nachobh/thermostat/WhatsApp Image 2026-09-09 at 20.18.24-2.jpeg

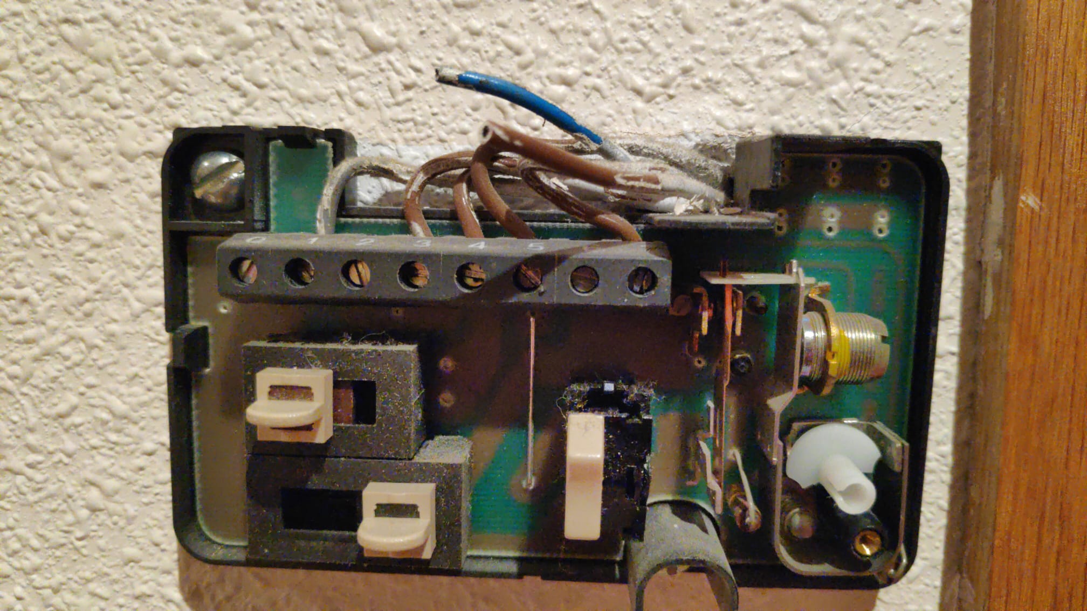
WhatsApp Image 2026-09-09 at 20.18.24-2.jpeg
