nachobh/thermostat/carcasa/esquema_medidas.png

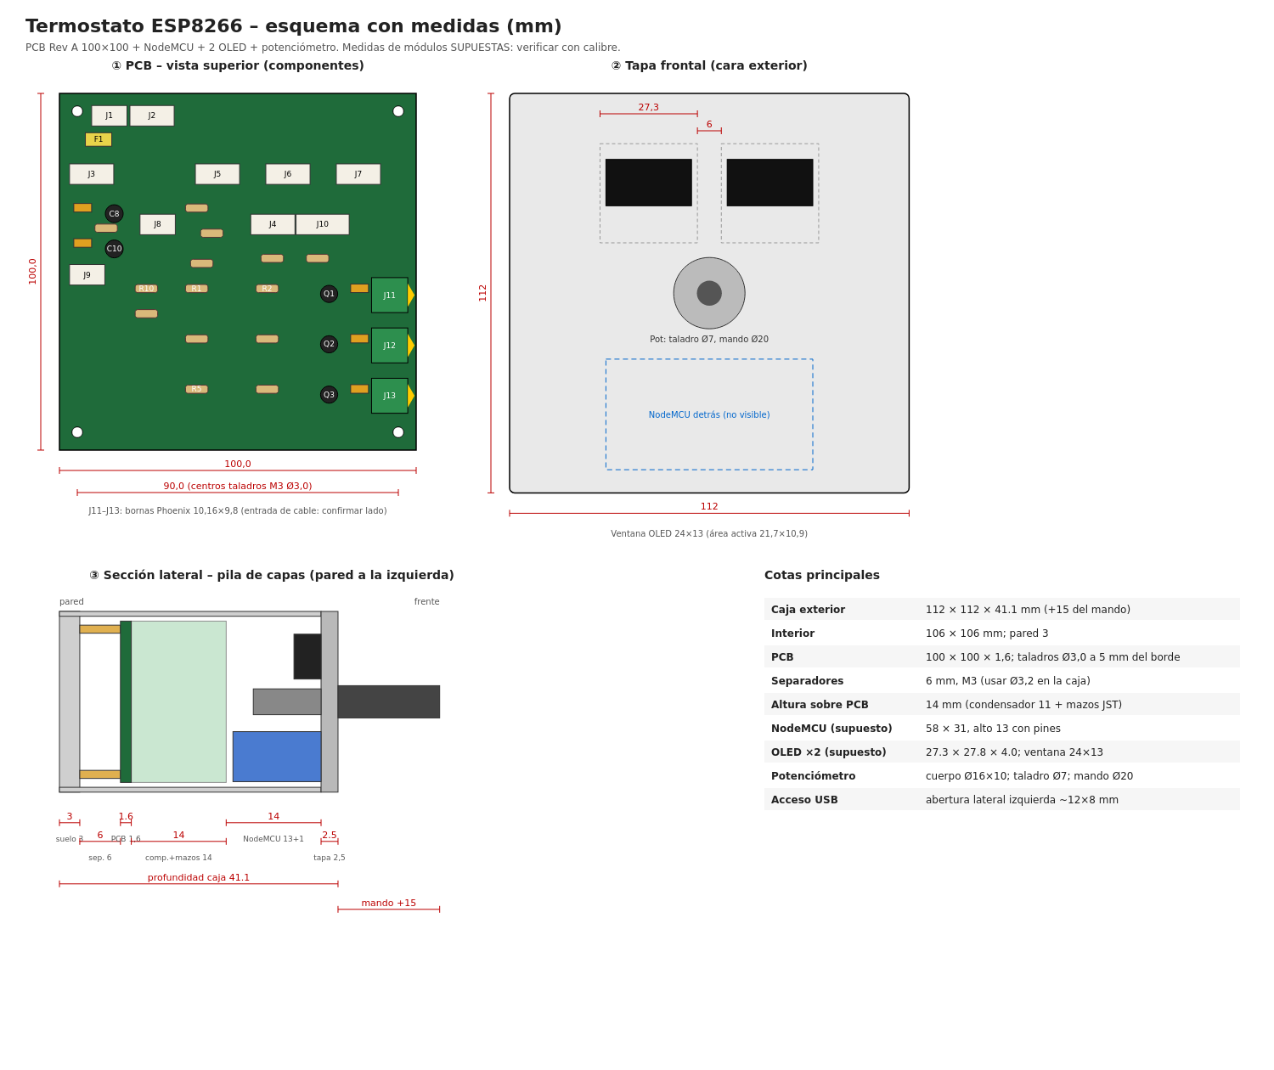
carcasa/esquema_medidas.png
