nachobh/thermostat/carcasa/esquema_v2.png

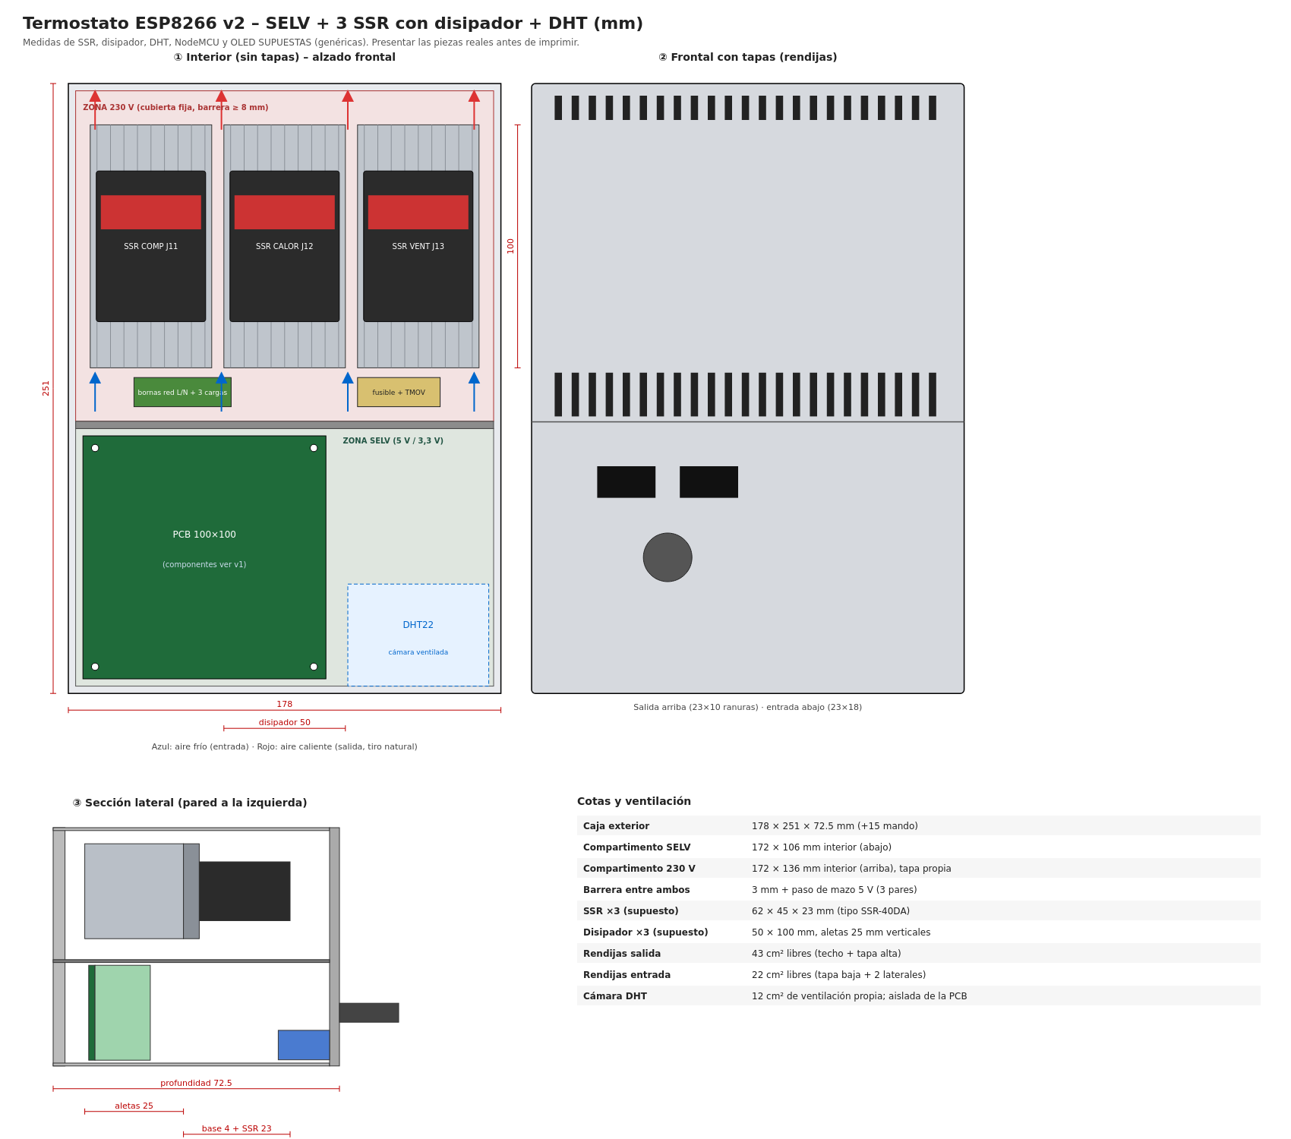
carcasa/esquema_v2.png
