nachobh/thermostat/carcasa/esquema_v3.png

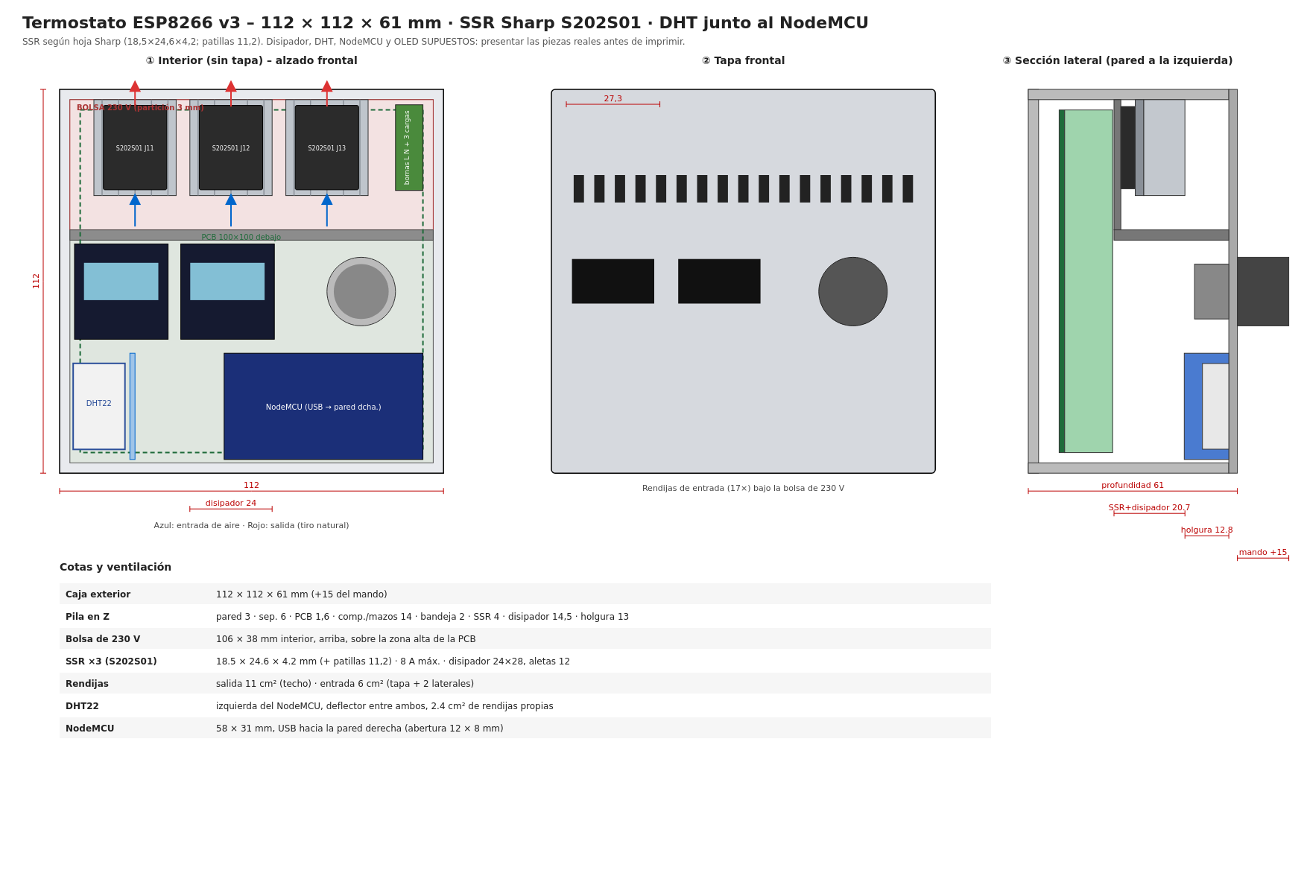
carcasa/esquema_v3.png
