nachobh/thermostat/carcasa/esquema_v5.png

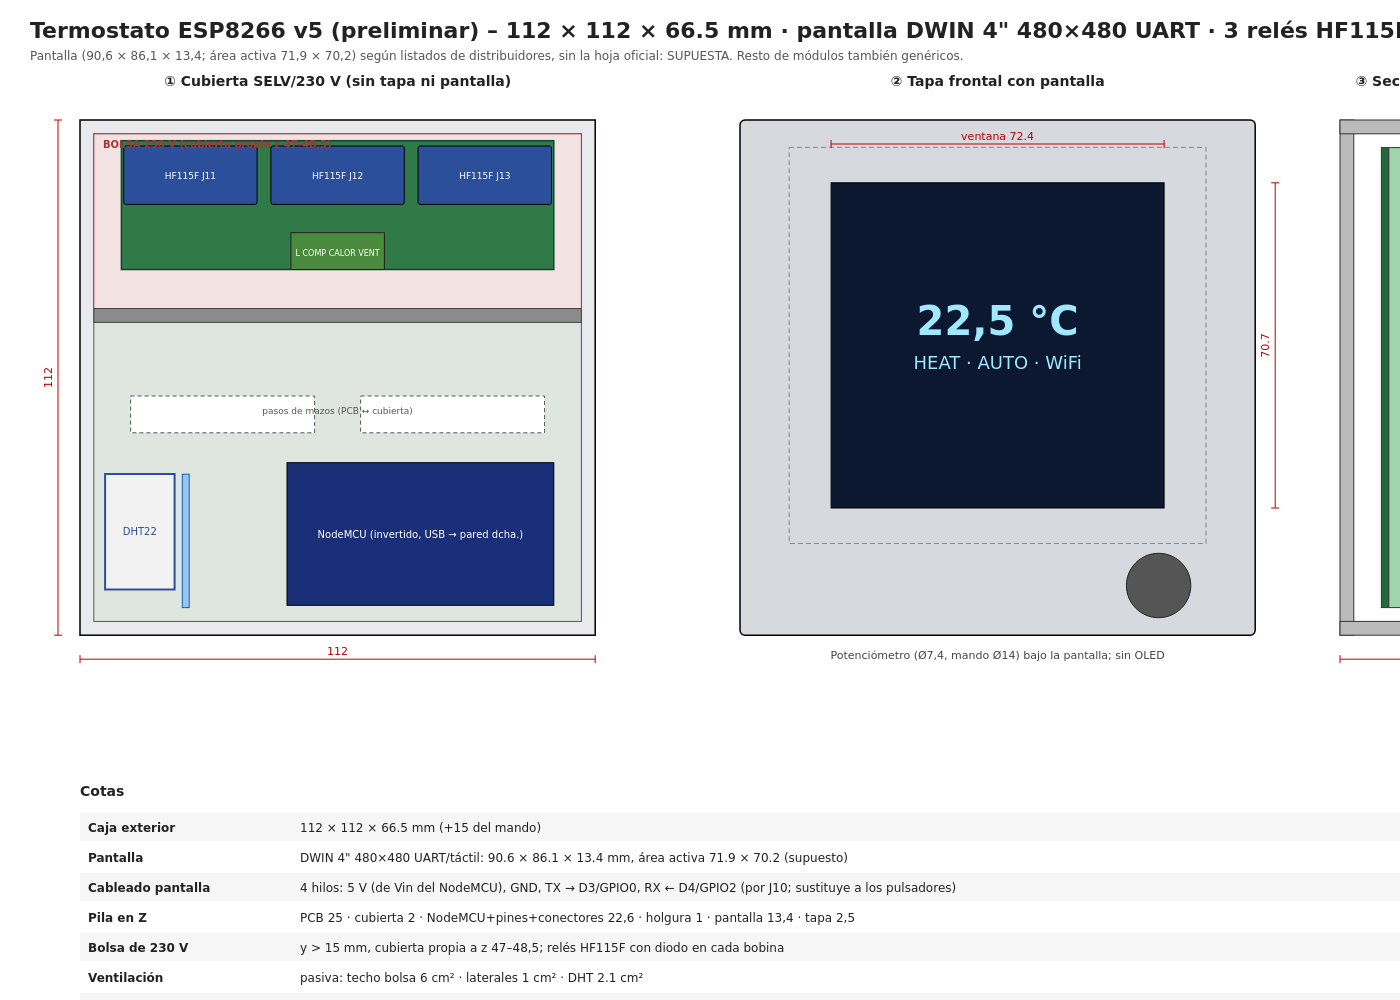
carcasa/esquema_v5.png
