nachobh/thermostat/carcasa/esquema_v6.png

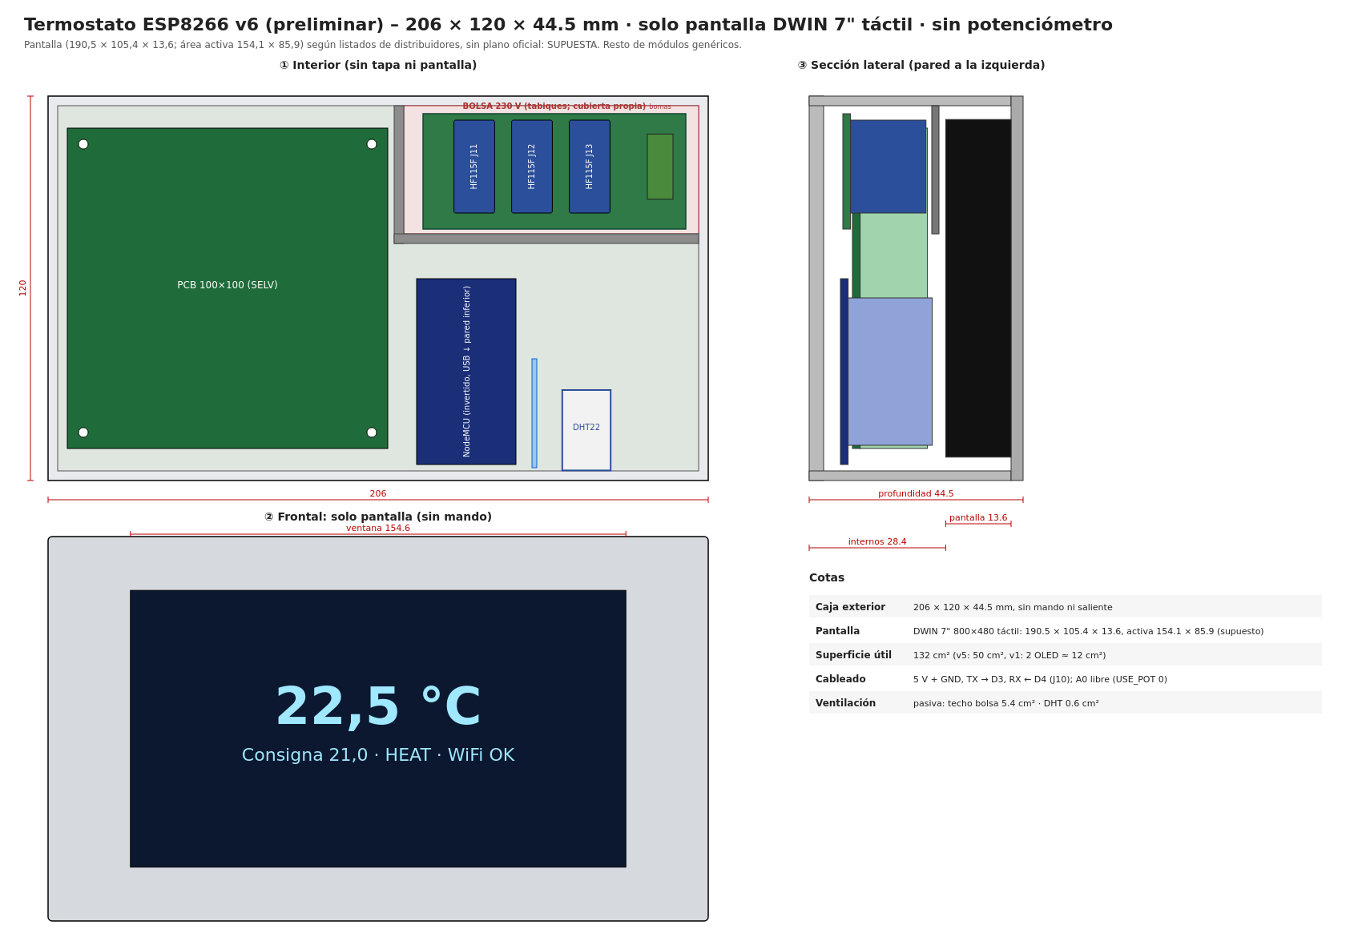
carcasa/esquema_v6.png
