nachobh/thermostat/carcasa/esquema_v7.png

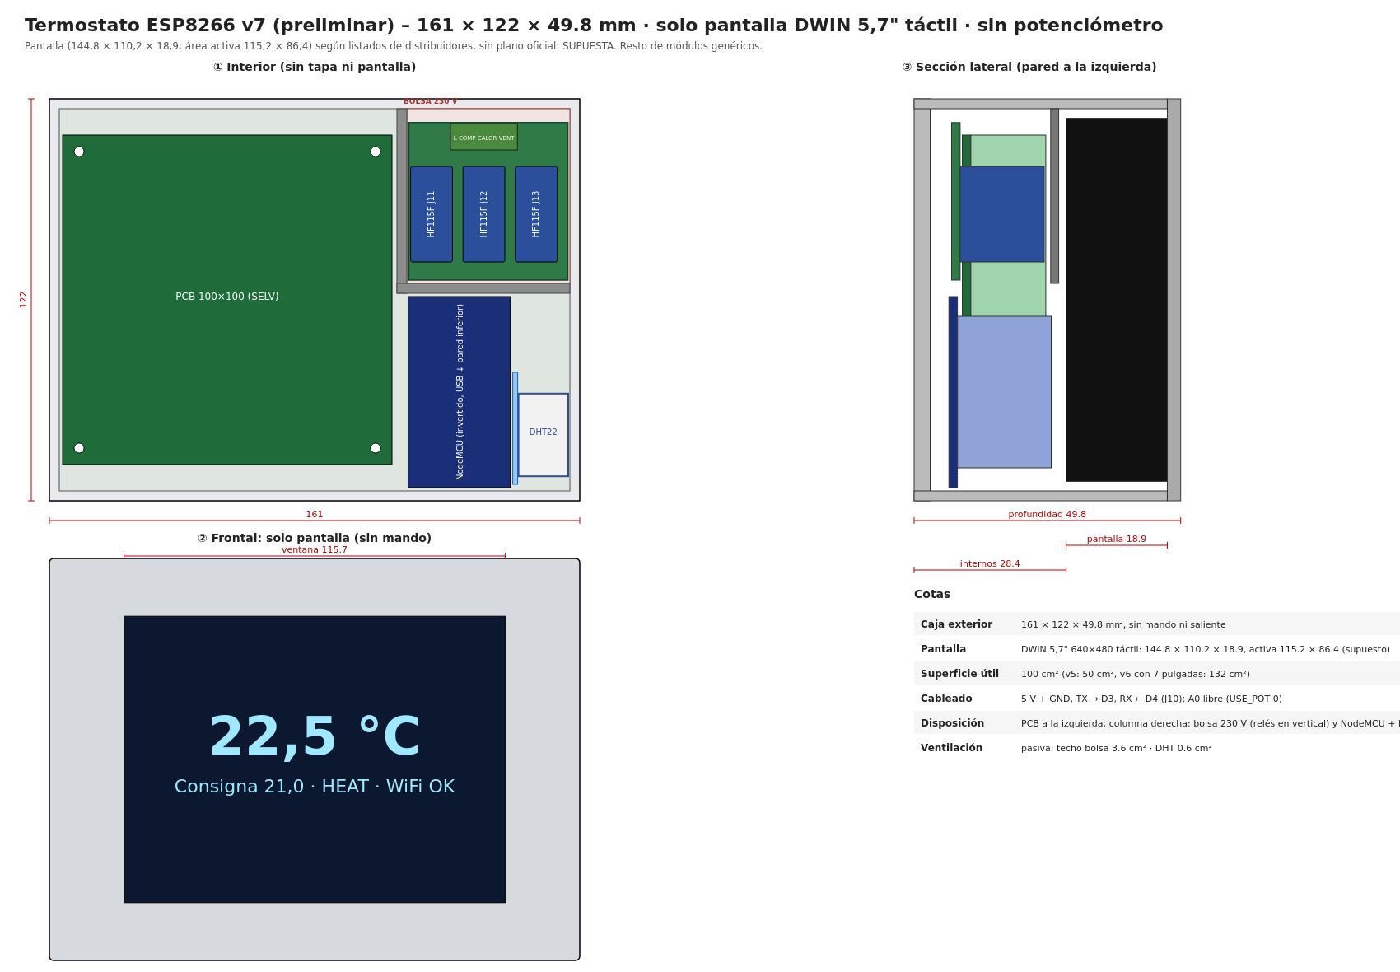
carcasa/esquema_v7.png
