nachobh/thermostat/carcasa/esquema_v8.png

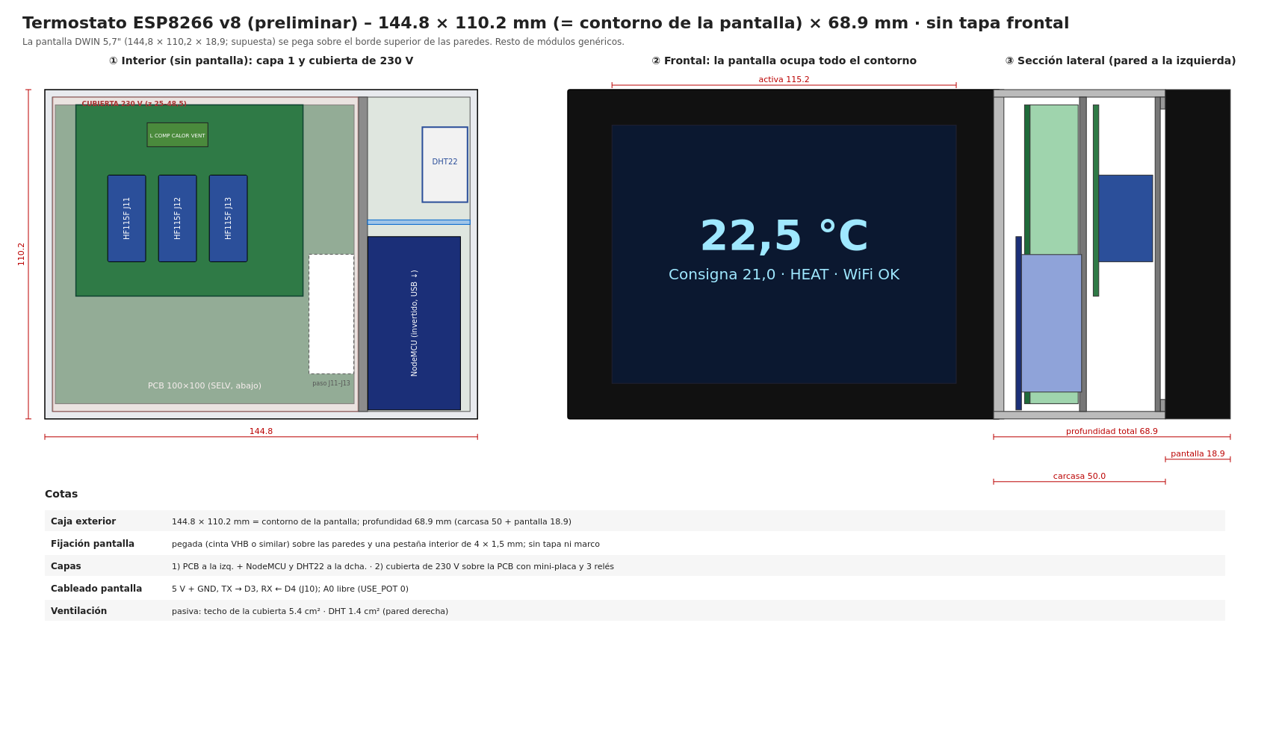
carcasa/esquema_v8.png
