nachobh/thermostat/carcasa/esquema_v9.png

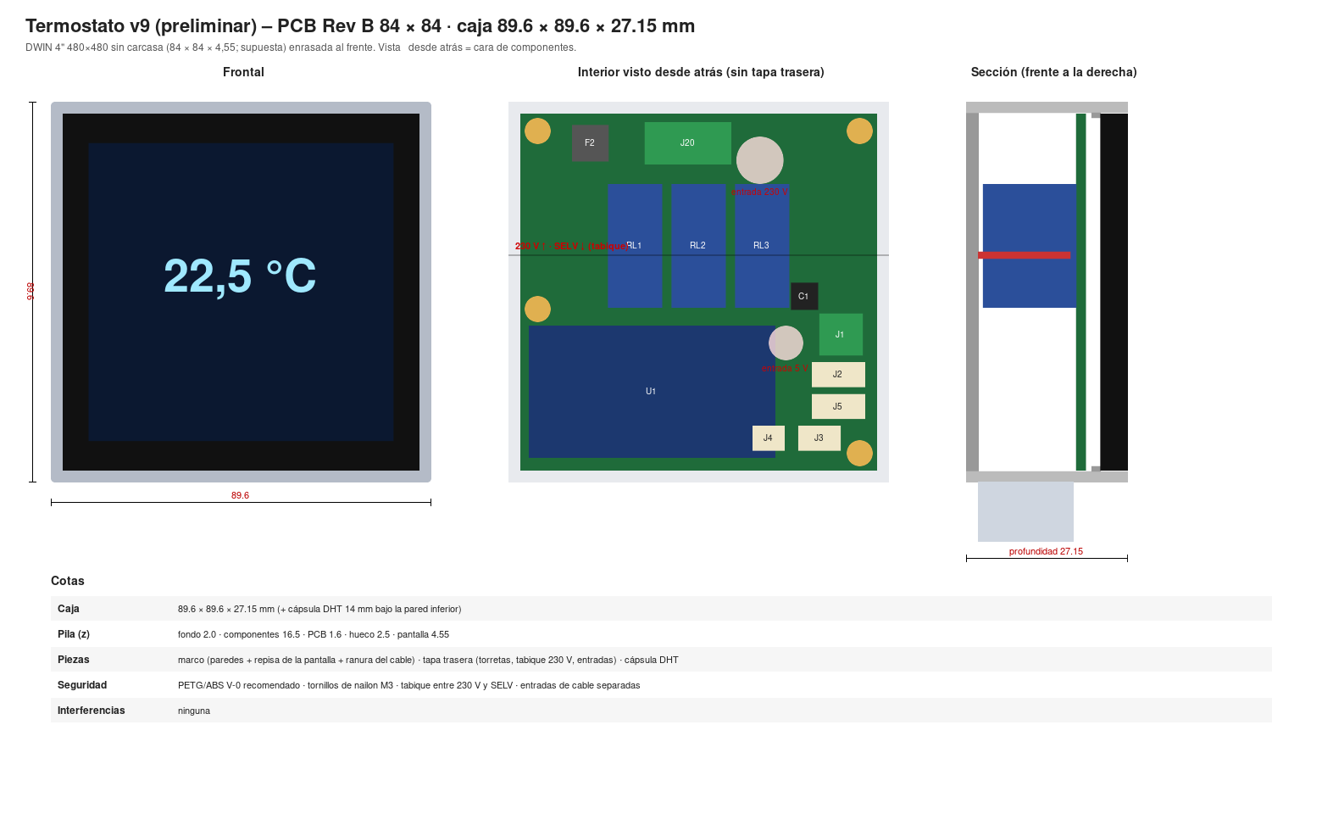
carcasa/esquema_v9.png
