nachobh/thermostat/carcasa/render_con_carcasa.png

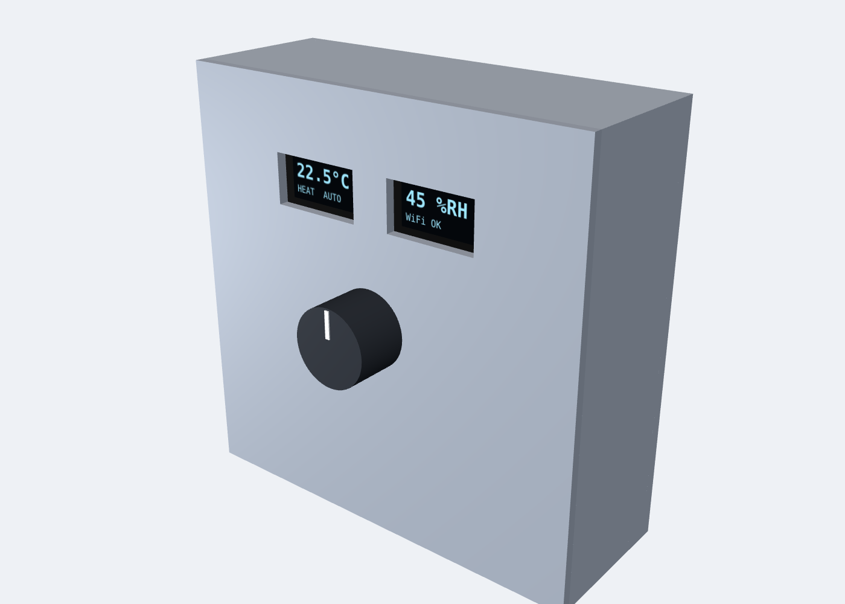
carcasa/render_con_carcasa.png
