nachobh/thermostat/carcasa/render_despiece.png

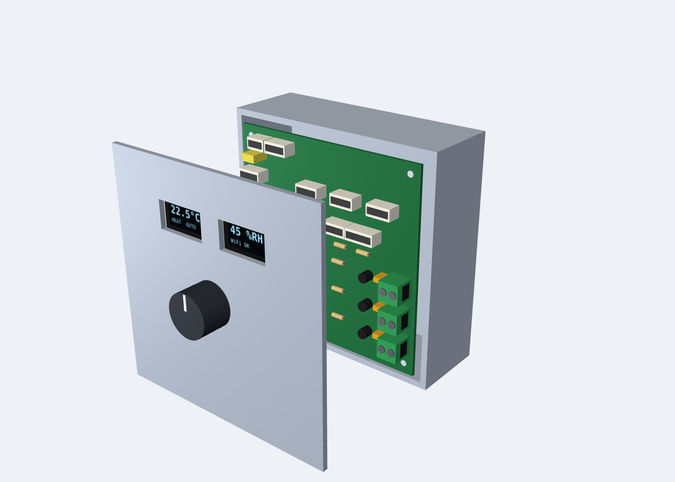
carcasa/render_despiece.png
