nachobh/thermostat/carcasa/render_frontal.png

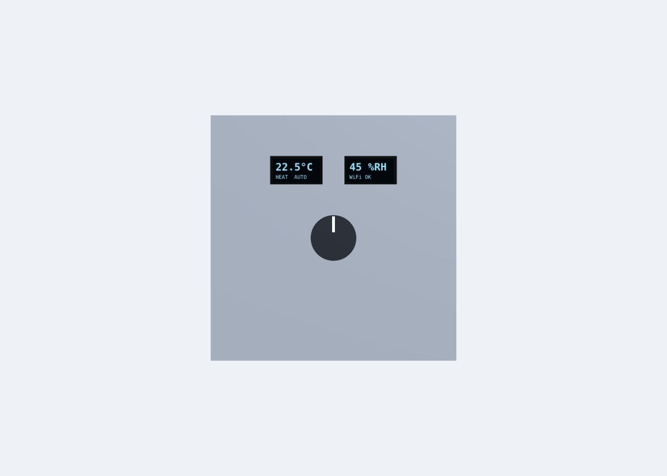
carcasa/render_frontal.png
