nachobh/thermostat/carcasa/render_lateral.png

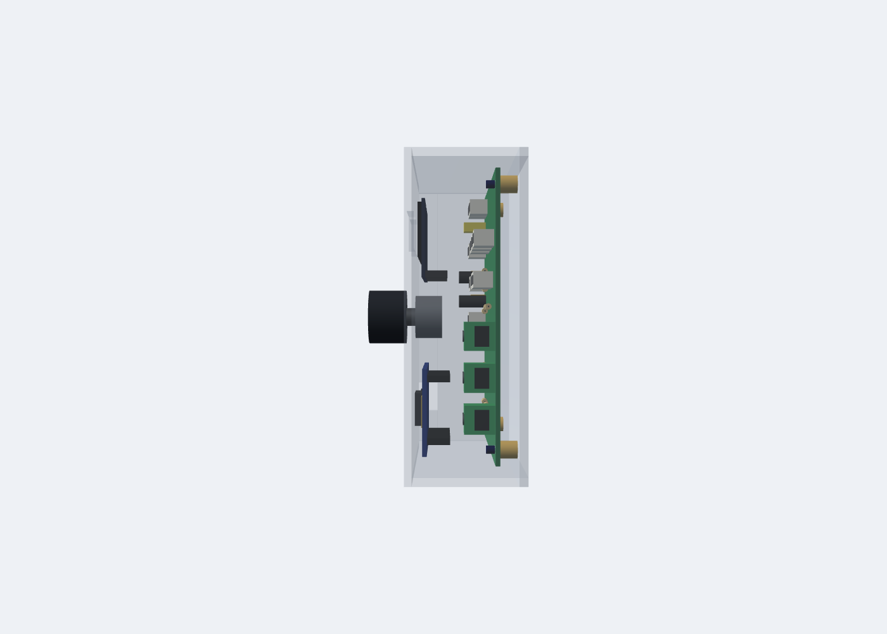
carcasa/render_lateral.png
