nachobh/thermostat/carcasa/render_sin_carcasa.png

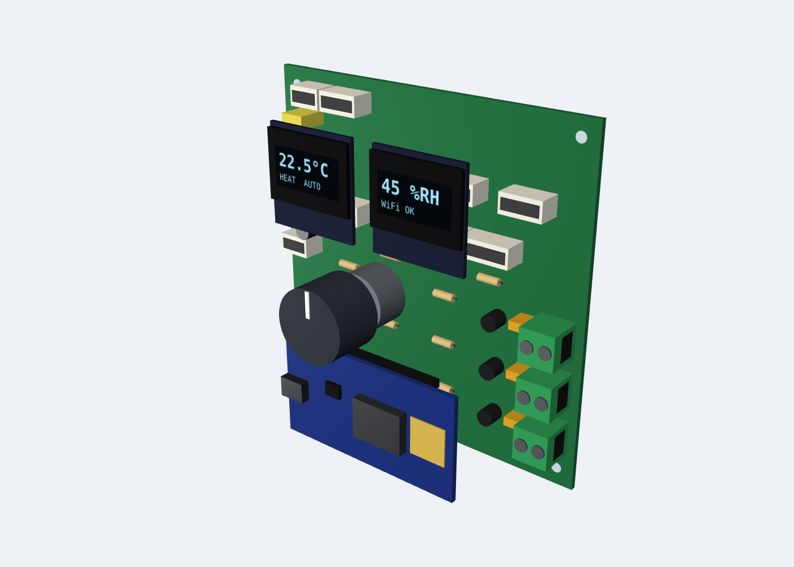
carcasa/render_sin_carcasa.png
