nachobh/thermostat/carcasa/render_transparente.png

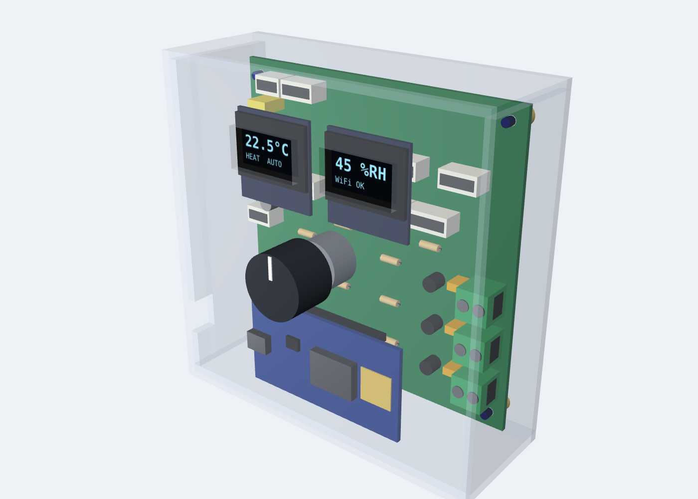
carcasa/render_transparente.png
