nachobh/thermostat/carcasa/render_v2_con_carcasa.png

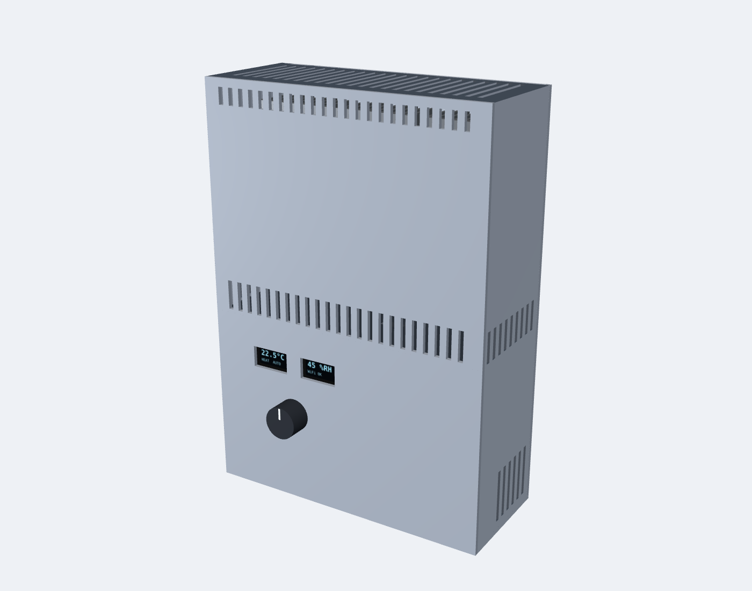
carcasa/render_v2_con_carcasa.png
