nachobh/thermostat/carcasa/render_v2_despiece.png

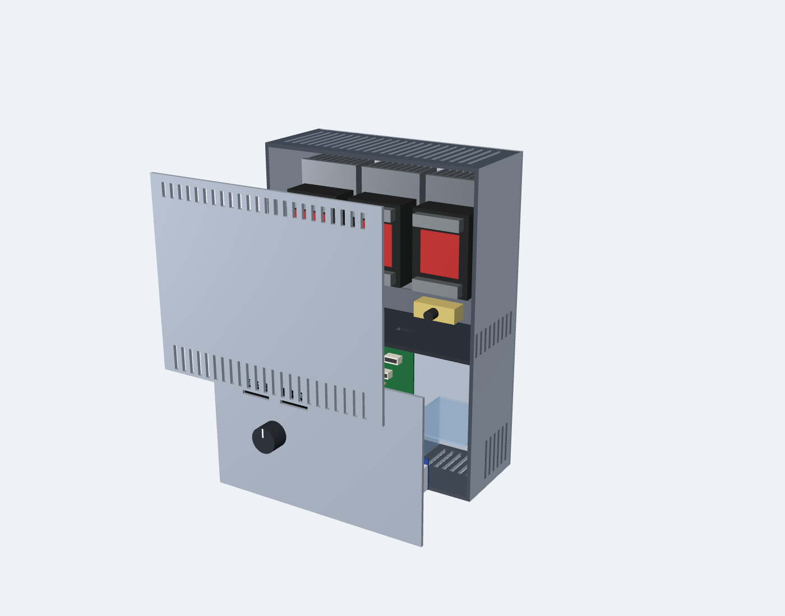
carcasa/render_v2_despiece.png
