nachobh/thermostat/carcasa/render_v2_sin_carcasa.png

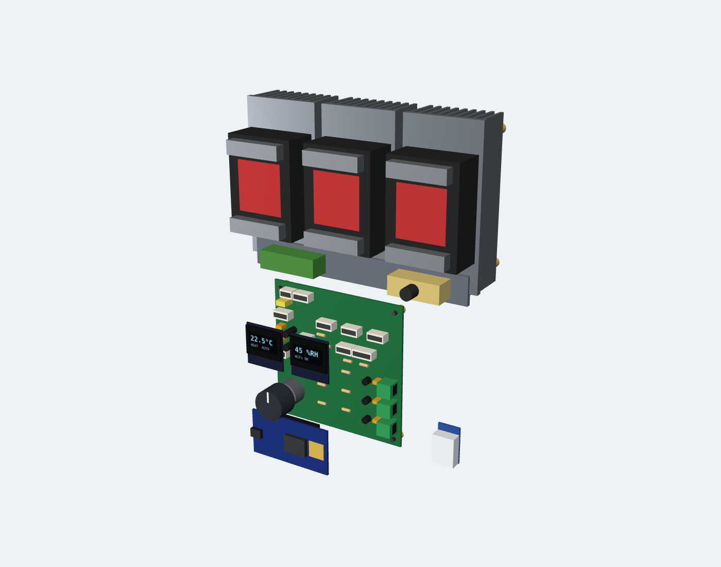
carcasa/render_v2_sin_carcasa.png
