nachobh/thermostat/carcasa/render_v2_transparente.png

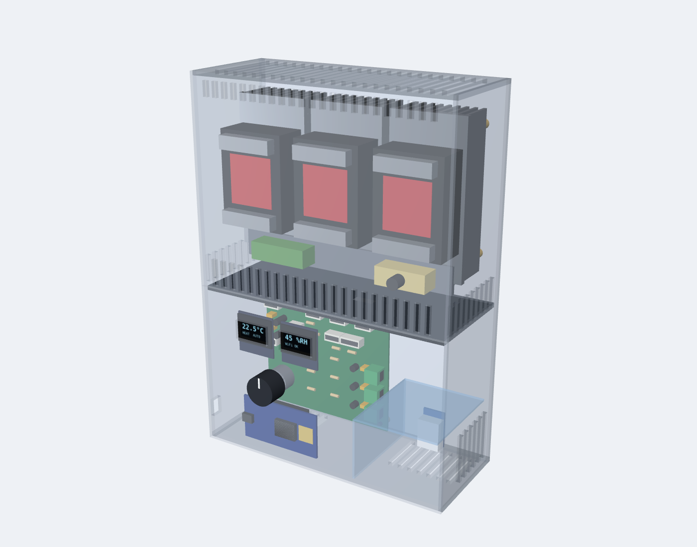
carcasa/render_v2_transparente.png
