nachobh/thermostat/carcasa/render_v3_con_carcasa.png

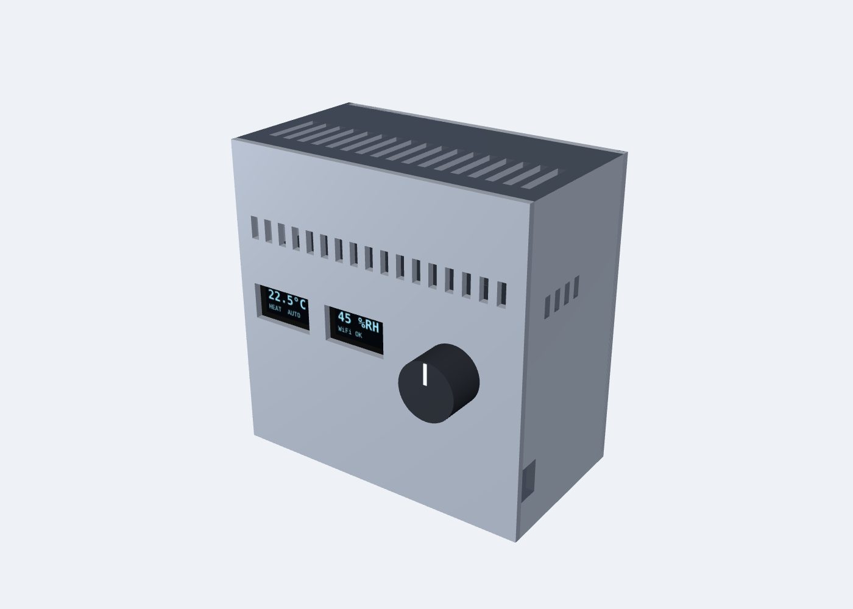
carcasa/render_v3_con_carcasa.png
