nachobh/thermostat/carcasa/render_v3_sin_carcasa.png

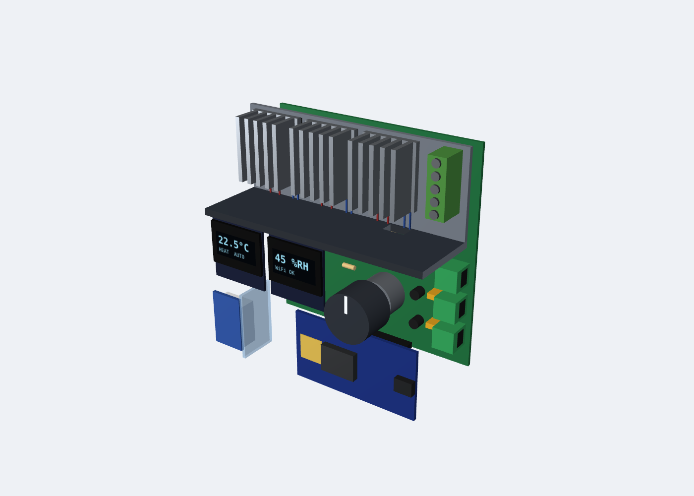
carcasa/render_v3_sin_carcasa.png
