nachobh/thermostat/carcasa/render_v4_frontal.png

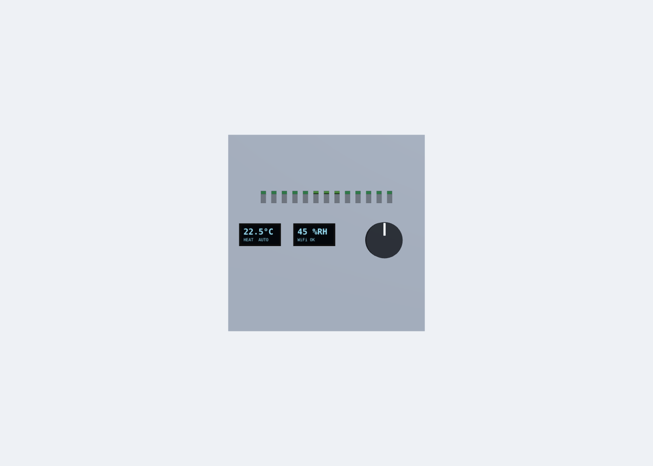
carcasa/render_v4_frontal.png
