nachobh/thermostat/carcasa/render_v4_transparente.png

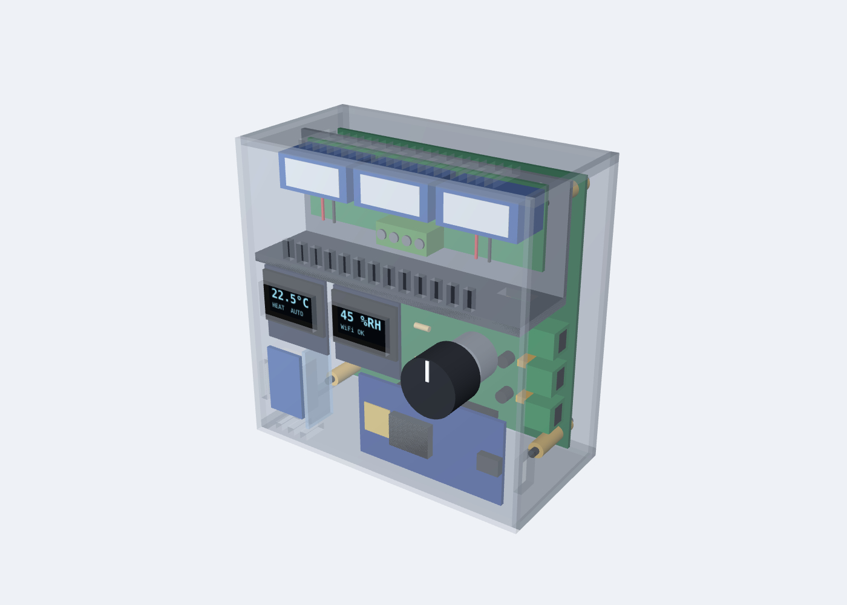
carcasa/render_v4_transparente.png
