nachobh/thermostat/carcasa/render_v5_sin_carcasa.png

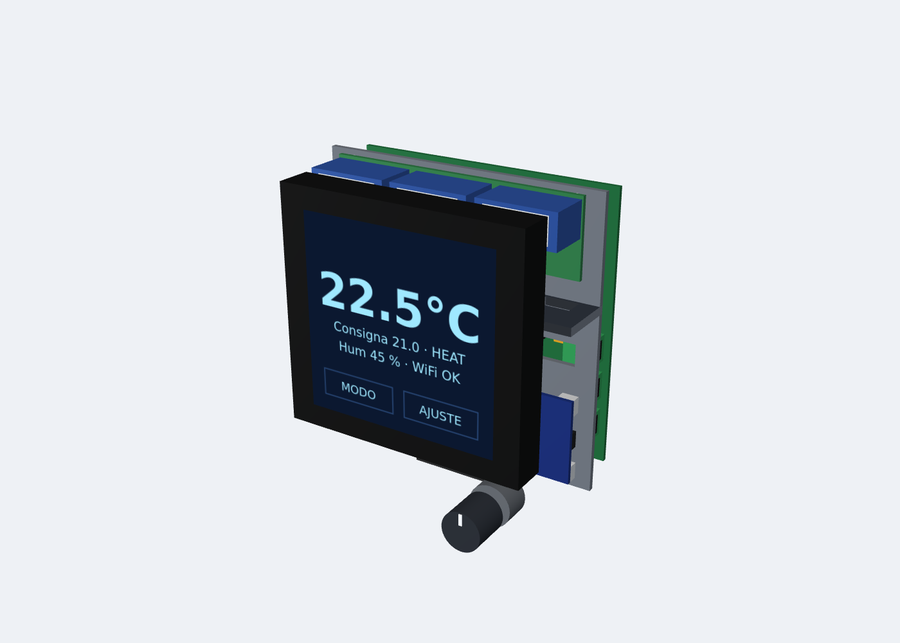
carcasa/render_v5_sin_carcasa.png
