nachobh/thermostat/carcasa/render_v5_transparente.png

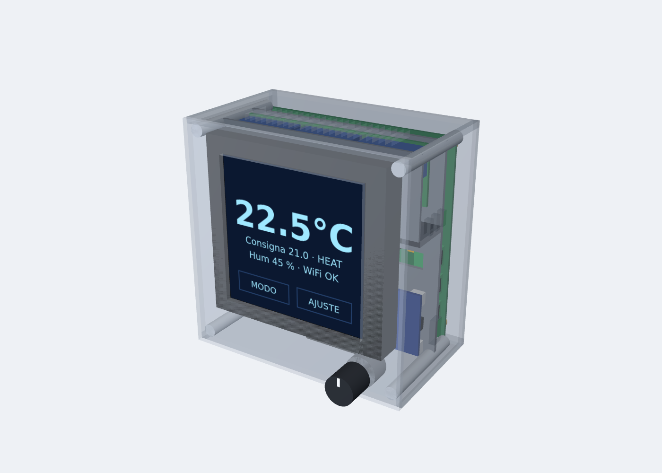
carcasa/render_v5_transparente.png
