nachobh/thermostat/carcasa/render_v6_con_carcasa.png

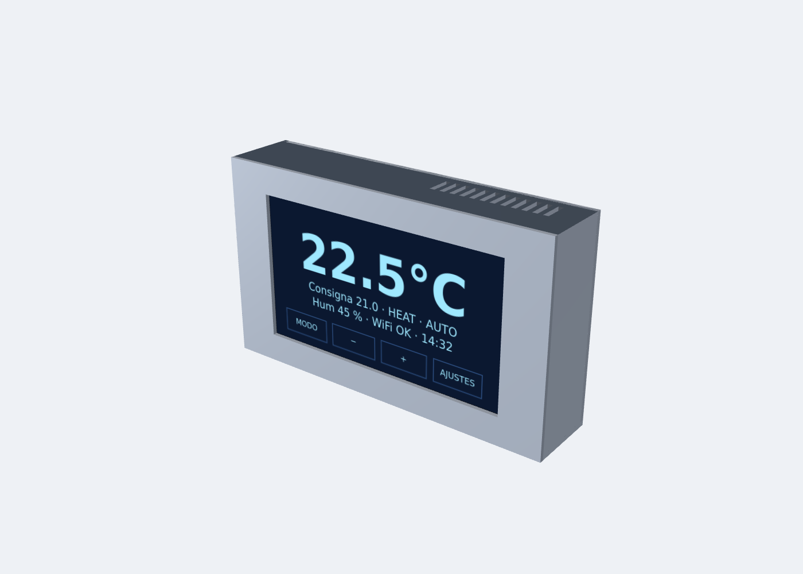
carcasa/render_v6_con_carcasa.png
