nachobh/thermostat/carcasa/render_v6_despiece.png

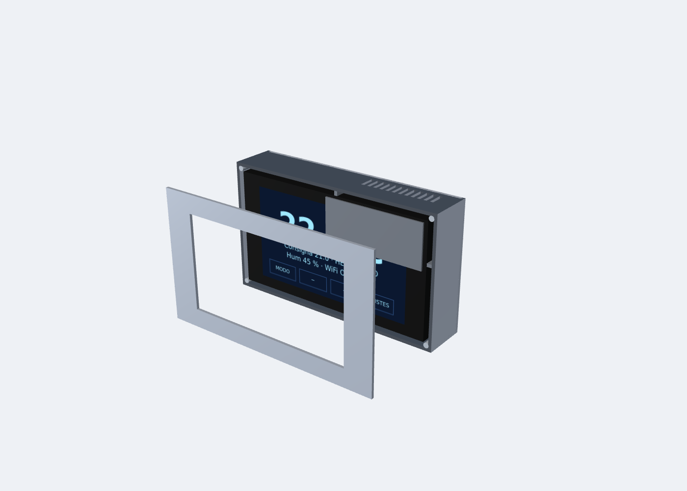
carcasa/render_v6_despiece.png
