nachobh/thermostat/carcasa/render_v6_frontal.png

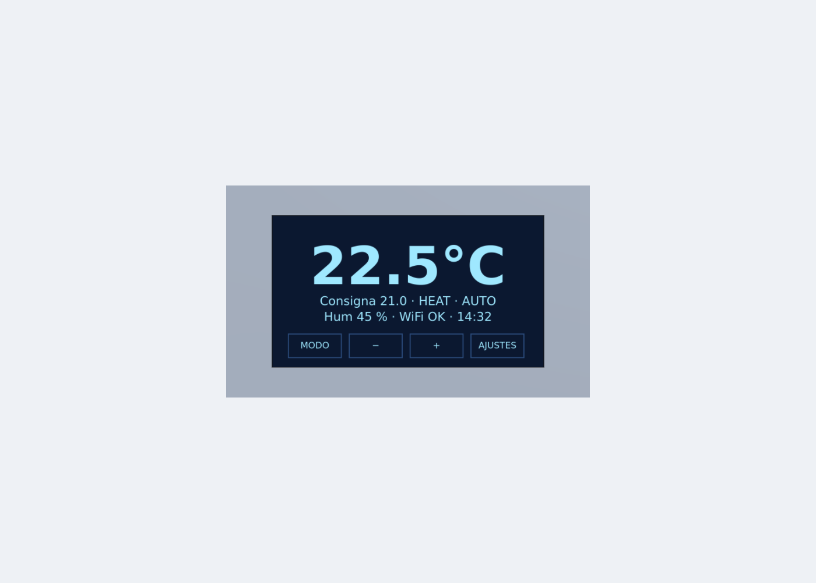
carcasa/render_v6_frontal.png
