nachobh/thermostat/carcasa/render_v6_sin_carcasa.png

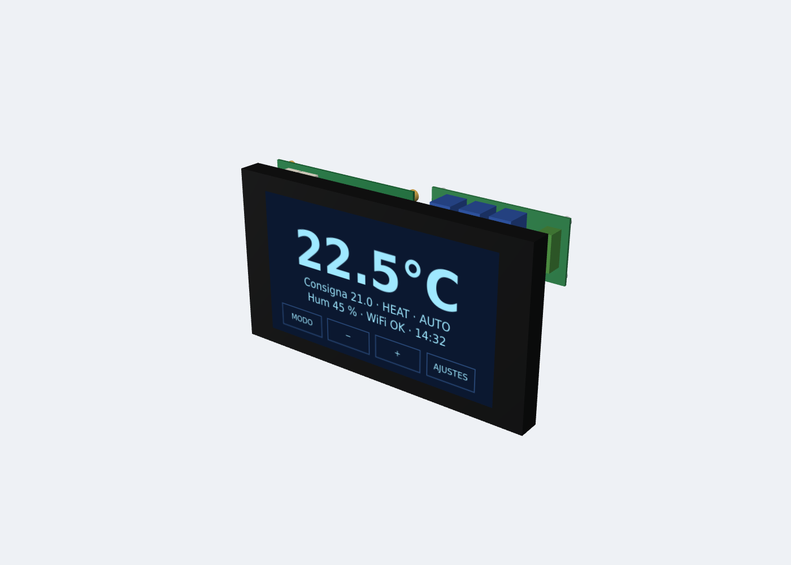
carcasa/render_v6_sin_carcasa.png
