nachobh/thermostat/carcasa/render_v7_frontal.png

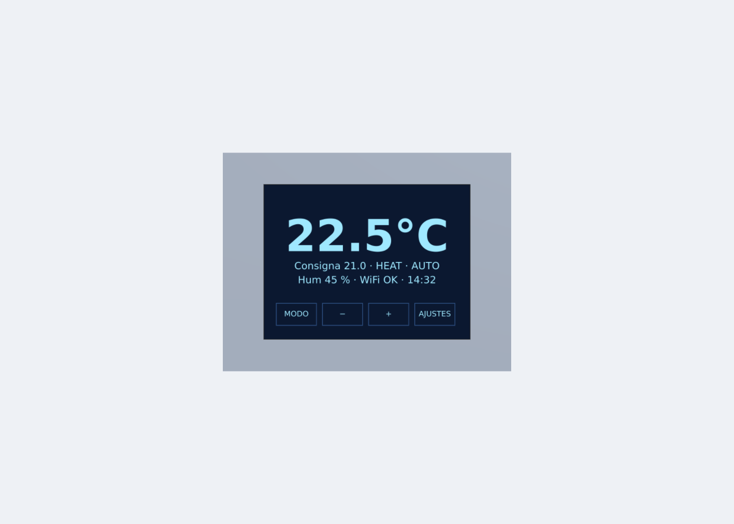
carcasa/render_v7_frontal.png
