nachobh/thermostat/carcasa/render_v8_con_carcasa.png

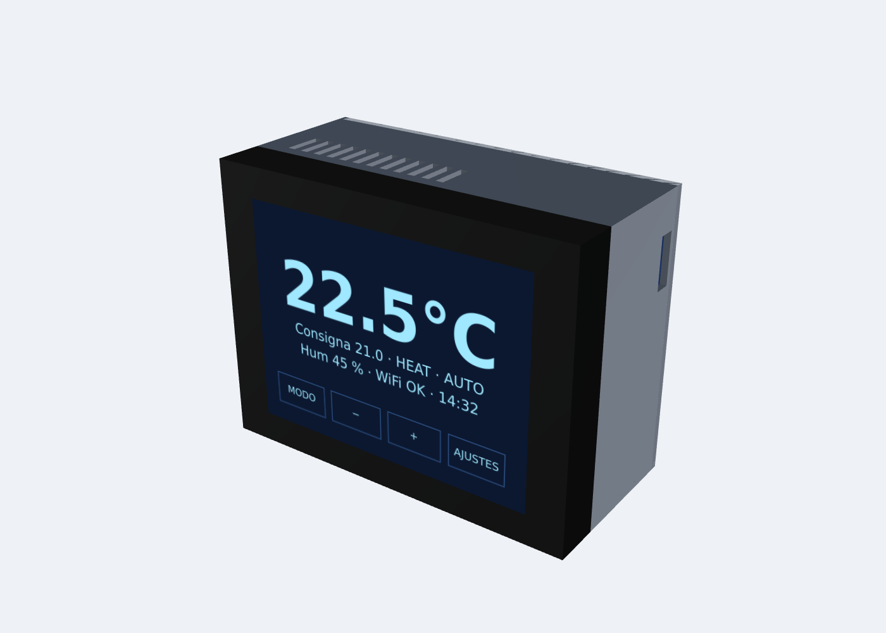
carcasa/render_v8_con_carcasa.png
