nachobh/thermostat/carcasa/render_v8_despiece.png

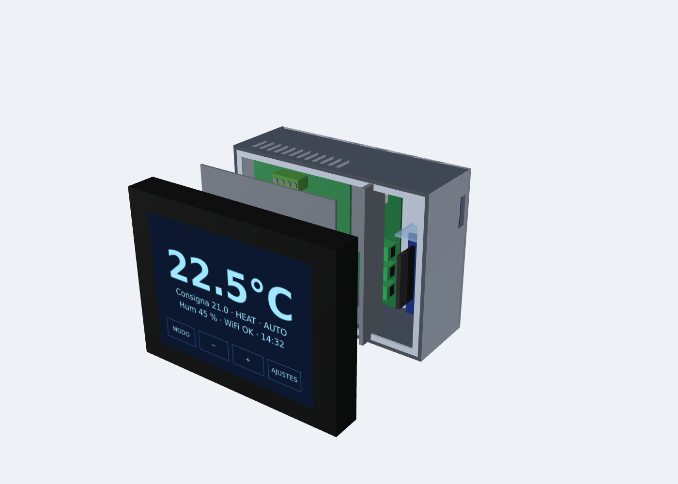
carcasa/render_v8_despiece.png
