nachobh/thermostat/carcasa/render_v9_iso.png

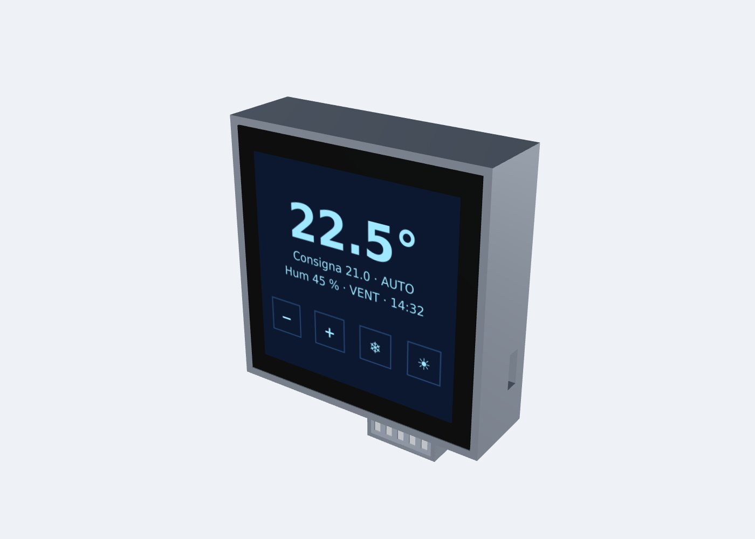
carcasa/render_v9_iso.png
