nachobh/thermostat/carcasa/render_v9_trasera_sin_caja.png

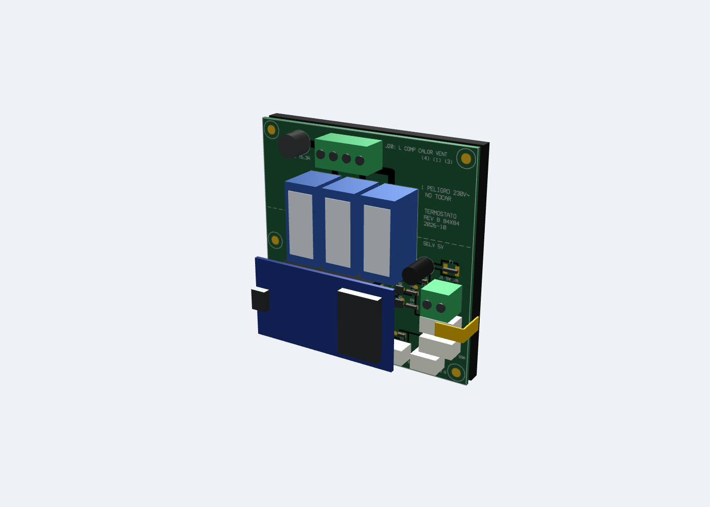
carcasa/render_v9_trasera_sin_caja.png
