nachobh/thermostat/carcasa/render_v10_despiece.png

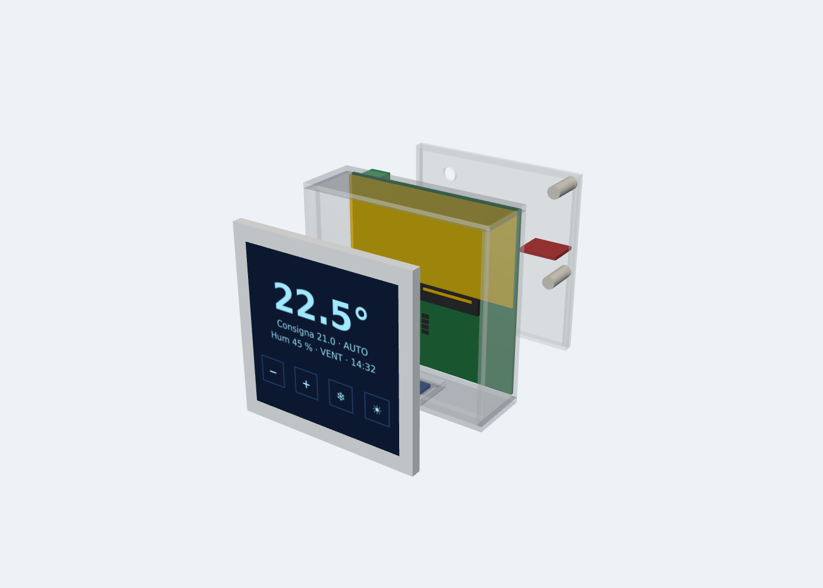
carcasa/render_v10_despiece.png
