nachobh/thermostat/carcasa/stl_bandeja.png

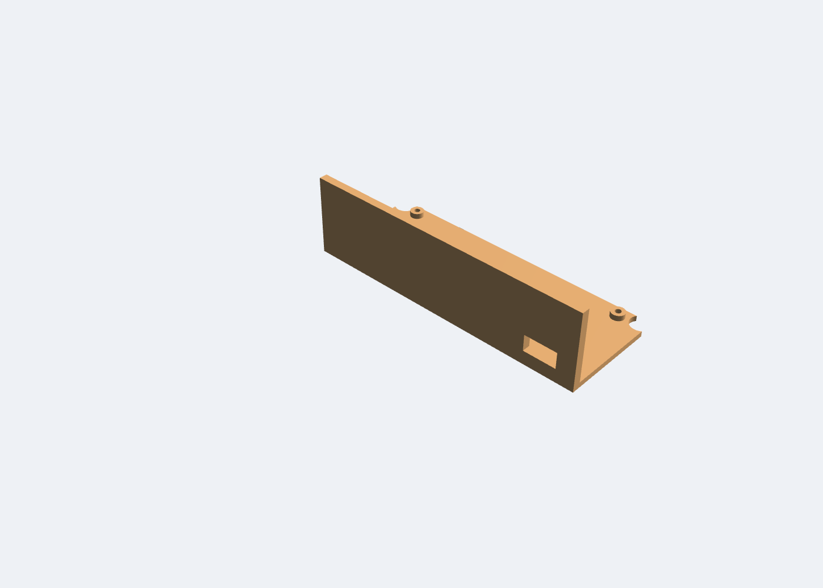
carcasa/stl_bandeja.png
