nachobh/thermostat/carcasa/stl_carcasa.png

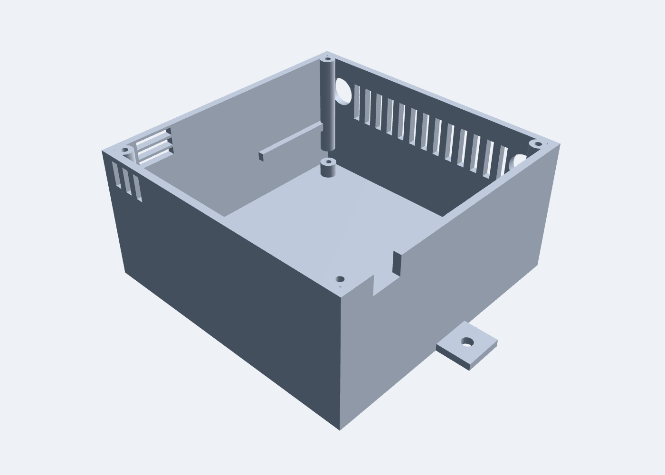
carcasa/stl_carcasa.png
