nachobh/thermostat/carcasa/stl_tapa.png

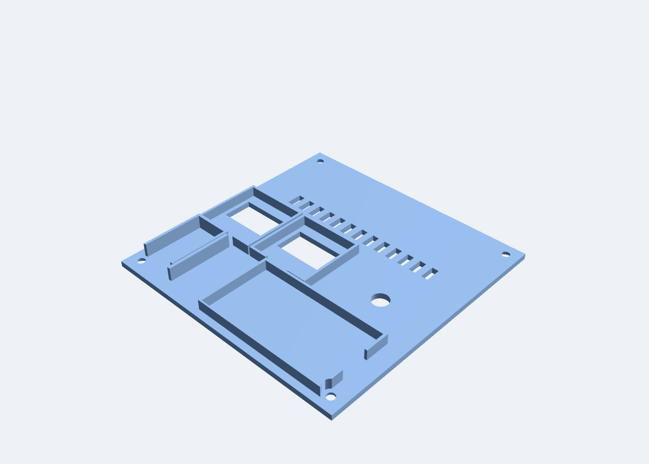
carcasa/stl_tapa.png
