nachobh/thermostat/carcasa/stl_v5_cubierta.png

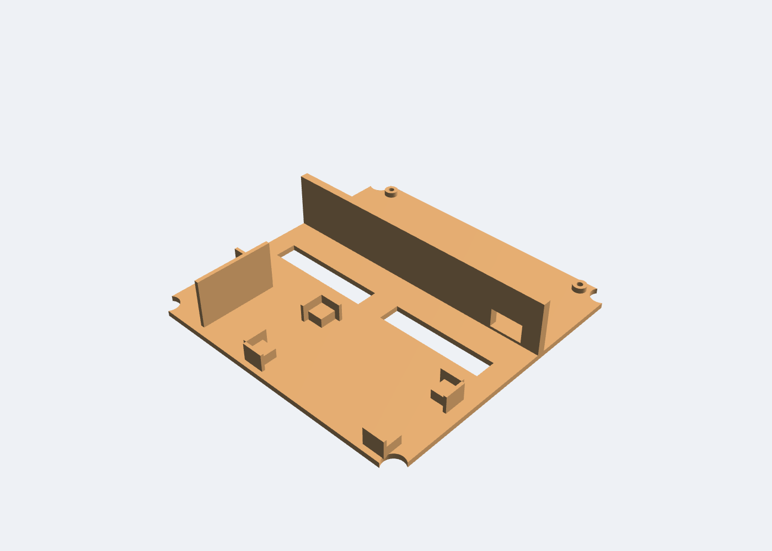
carcasa/stl_v5_cubierta.png
