nachobh/thermostat/carcasa/stl_v5_tapa.png

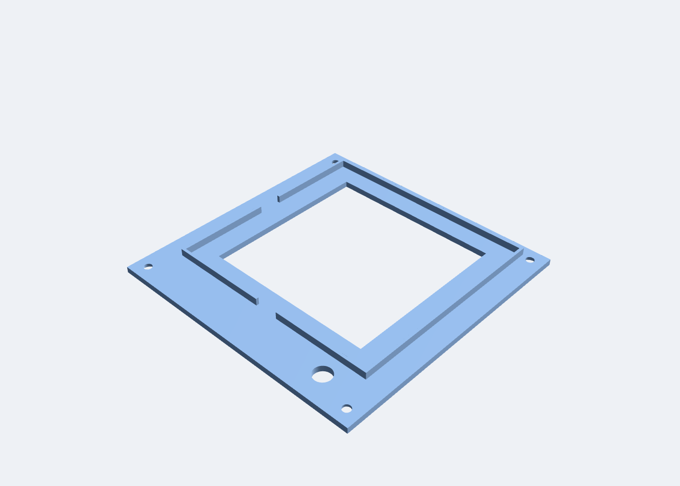
carcasa/stl_v5_tapa.png
