nachobh/thermostat/carcasa/stl_v6_carcasa.png

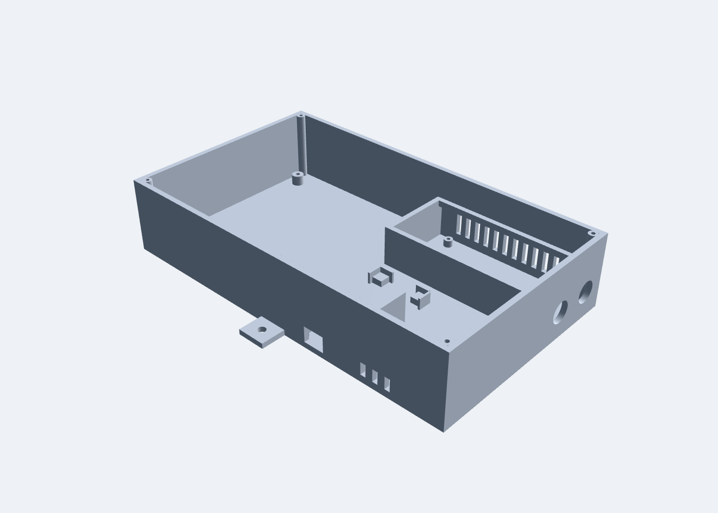
carcasa/stl_v6_carcasa.png
