nachobh/thermostat/carcasa/stl_v7_carcasa.png

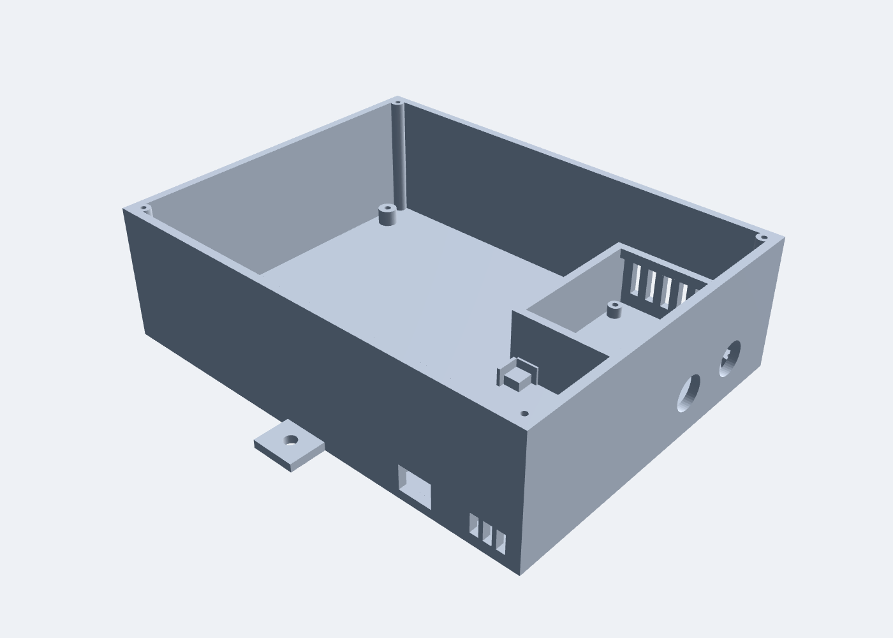
carcasa/stl_v7_carcasa.png
