nachobh/thermostat/carcasa/stl_v8_carcasa.png

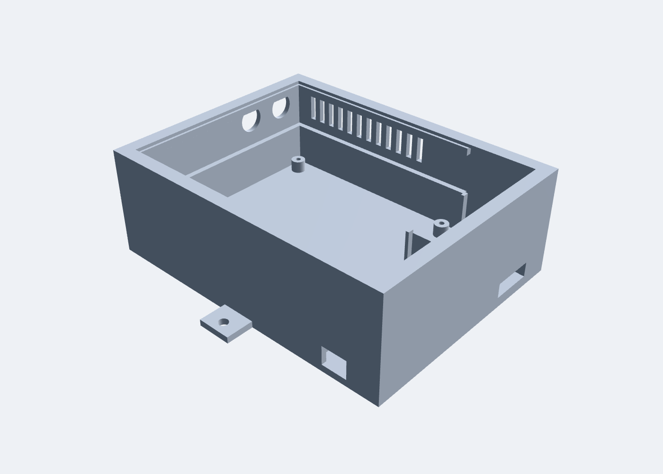
carcasa/stl_v8_carcasa.png
