nachobh/thermostat/pcbway/thermostat_rev_c/ESQUEMA_REV_C.png

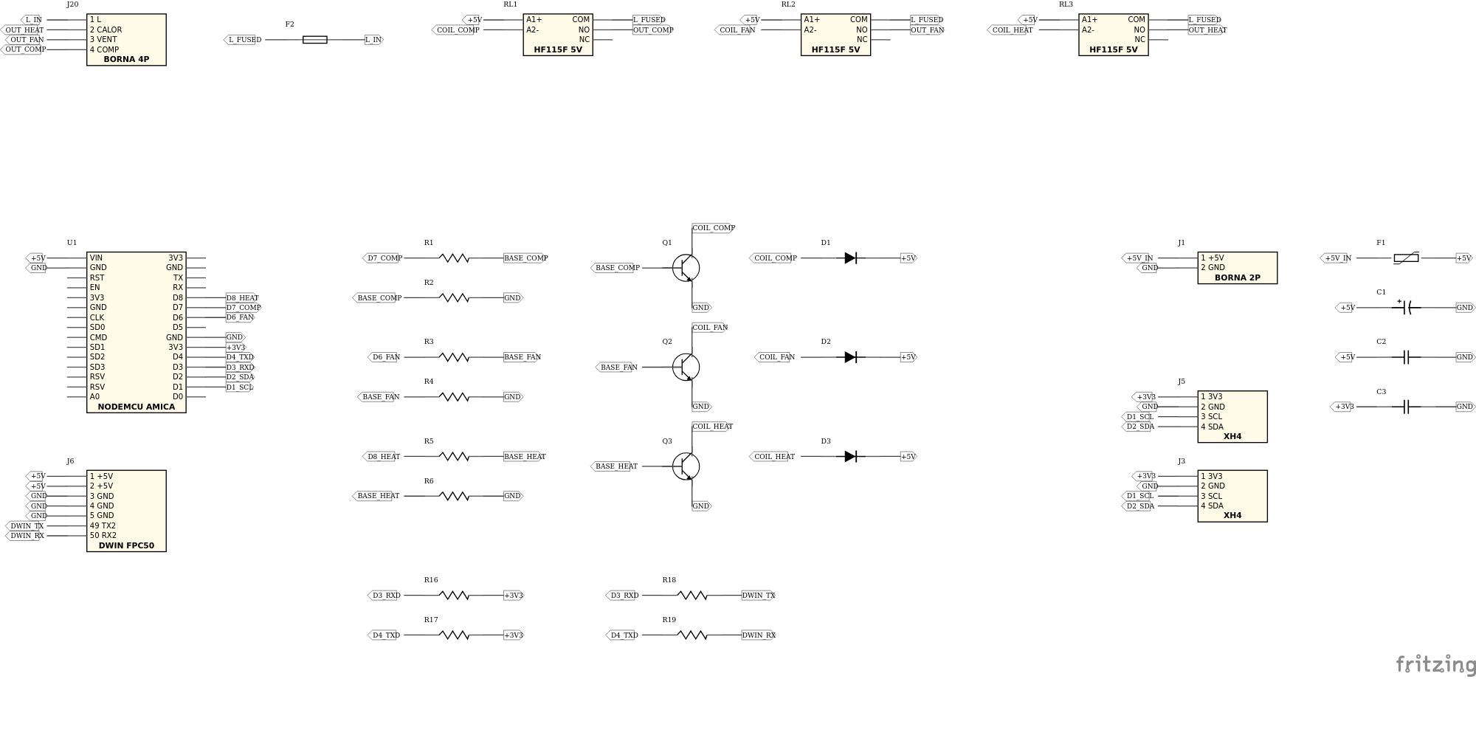
pcbway/thermostat_rev_c/ESQUEMA_REV_C.png
