nachobh/thermostat/WhatsApp Image 2026-09-09 at 19.58.45-2.jpeg

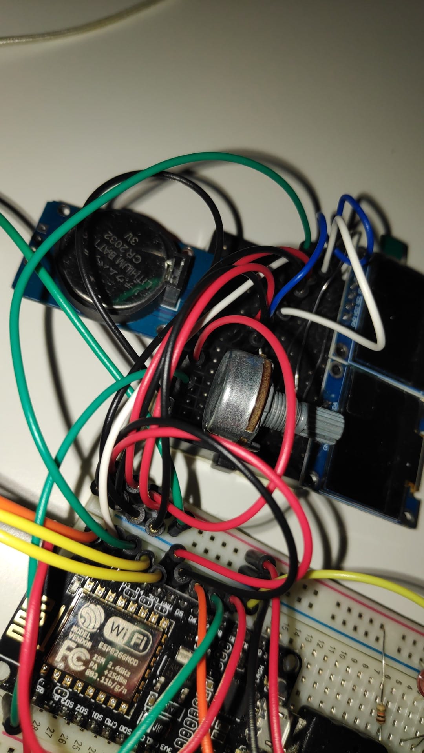
WhatsApp Image 2026-09-09 at 19.58.45-2.jpeg
