nachobh/thermostat/WhatsApp Image 2026-09-09 at 20.16.29.jpeg

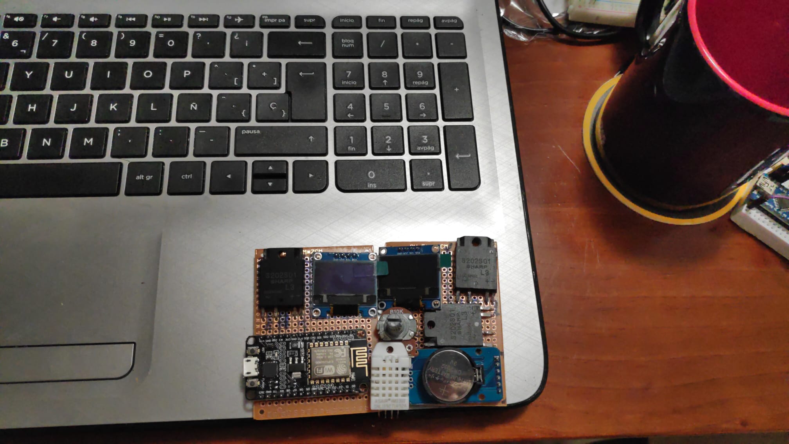
WhatsApp Image 2026-09-09 at 20.16.29.jpeg
