nachobh/thermostat/pcbway/thermostat_universal_rev_a/BOM_MONTAJE_MANUAL.csv

Referencias | Cantidad | Valor/función | Formato de la PCB | Referencia de compra o especificación | Montaje | Observaciones
J1 J8 J9 | 3 | JST XH 3 vías | 2.50 mm; 0.90 mm PTH | JST B3B-XH-A | SÍ | Versión SIN boss; NO sustituir por B3B-XH-AM. Mazo XHP-3 + SXH-001T-P0.6
J2 J3 J4 J5 J6 J7 | 6 | JST XH 4 vías | 2.50 mm; 0.90 mm PTH | JST B4B-XH-A | SÍ | Versión SIN boss; NO sustituir por B4B-XH-AM. Mazo XHP-4 + SXH-001T-P0.6
J10 | 1 | JST XH 5 vías | 2.50 mm; 0.90 mm PTH | JST B5B-XH-A | SÍ | Versión SIN boss; NO sustituir por B5B-XH-AM. Mazo XHP-5 + SXH-001T-P0.6
J11 J12 J13 | 3 | Borna de control SSR 2 vías | 5.08 mm; 1.30 mm PTH | Phoenix Contact MKDS 1,5/ 2-5,08; 1715721 | SÍ | Sólo 5 V SELV; pin 1 +5 V; pin 2 CTRL−
F1 | 1 | PTC 0.30 A hold | 5.08 mm PTH | Littelfuse RXEF030; RF2565-000 | SÍ | Protege únicamente la rama +5 V de entradas SSR
Q1 Q2 Q3 | 3 | NPN BC547B | TO-92 C-B-E en línea; paso 2.54 mm; taladro 0.90 mm | Diotec BC547B TO-92 en cinta, NO variante BK de 1.27 mm | SÍ | Cara plana hacia línea recta de serigrafía; C/B/E marcados; presentar terminales antes de soldar
R1 R3 R5 | 3 | 1 kΩ 0.25 W | Axial THT; paso 10.16 mm | Resistencia axial 1 kΩ ±5 % | SÍ | Serie entre GPIO y base
R2 R4 R6 | 3 | 10 kΩ 0.25 W | Axial THT; paso 10.16 mm | Resistencia axial 10 kΩ ±5 % | SÍ | Pull-down base-emisor; imprescindible para GPIO15
R15 | 1 | 10 kΩ 0.25 W | Axial THT; paso 10.16 mm | Resistencia axial 10 kΩ ±5 % | SÍ | Pull-down D0/GPIO16; cable desconectado = OFF
R16 R17 | 2 | 10 kΩ 0.25 W | Axial THT; paso 10.16 mm | Resistencia axial 10 kΩ ±5 % | SÍ | Pull-up externos D3/GPIO0 y D4/GPIO2 para arranque
R7 R8 R9 | 3 | 4.7 kΩ 0.25 W | Axial THT; paso 10.16 mm | Resistencia axial 4.7 kΩ ±5 % | DNP | Montar sólo si las placas I²C/DHT no incorporan ya sus pull-ups
R10 R11 R12 R13 R14 | 5 | Puente 0 Ω | Axial THT; paso 10.16 mm | Puente de alambre aislado o resistor axial 0 Ω | SÍ | Cinco puentes obligatorios; no omitir
C1 C2 C3 C7 C9 | 5 | 100 nF 50 V | Cerámico radial; paso 2.54 mm | 100 nF X7R o cerámico radial ≥50 V | SÍ | C1–C3 en entradas SSR; C7 a 5 V; C9 a 3.3 V
C8 | 1 | 100 µF ≥10 V | Electrolítico radial Ø≤5 mm; paso 2.54 mm | 100 µF 10 V radial 5 × 11 mm | SÍ | Positivo a +5V_SSR, negativo a GND
C10 | 1 | 47 µF ≥10 V | Electrolítico radial Ø≤5 mm; paso 2.54 mm | 47 µF 10 V radial 5 × 11 mm | SÍ | Positivo a 3V3, negativo a GND
