nachobh/thermostat/pcbway/thermostat_rev_c/jlcpcb/BOM_JLCPCB.csv

Comment | Designator | Footprint | LCSC Part #
MKDS 4P 230V | J20 | TerminalBlock_P5.08mm_1x04
T6.3A 250V | F2 | Fuse_TR5_P5.08mm
HF115F/005-1ZS3 | RL1,RL2,RL3 | Relay_THT_HF115F-1ZS3 | C9225
NodeMCU Amica | U1 | 2x PinSocket_1x15_P2.54mm (rows 22.86 mm)
DWIN FPC50 | J6 | FPC_0.5mm_50P_AFC07 (bottom) | C262650
1k | R1,R3,R5,R18,R19 | R0805 | C17513
10k | R2,R4,R6,R16,R17 | R0805 | C17414
BC817-40 | Q1,Q2,Q3 | SOT-23-3 | C2982853
1N4148W | D1,D2,D3 | SOD-123 | C81598
5V IN | J1 | TerminalBlock_P5.08mm_1x02 | C480516
1.1A PTC | F1 | 1812 | C142746
220uF 16V | C1 | CP_Radial_D6.3mm_P2.50mm | C2886738
100nF | C2,C3 | C0805 | C49678
B4B-XH-A(LF)(SN) | J3,J5 | JST_XH_B4B-XH-A_1x04_P2.50mm_Vertical | C144395
