nachobh/thermostat/pcbway/thermostat_rev_c/PARA_SUBIR_PCBWAY/BOM_PCBWAY_REV_C.xlsx

Item # | Designator | Qty | Manufacturer | Mfg Part # | Description / Value | Package/Footprint | Type | Your Instructions / Notes
1 | J20 | 1 | Phoenix Contact | 1715747 (MKDS 1,5/4-5,08) | MKDS 4P 230V - Screw terminal 4P 5.08 mm 250 V 17.5 A (230 V side: COMP, VENT, CALOR, L) | TerminalBlock_P5.08mm_1x04 | THT
2 | F2 | 1 | Littelfuse | 37416300000 (TR5 T6.3A) | T6.3A 250V - Fuse TR5 time-lag 6.3 A 250 VAC, 5.08 mm (alt. Schurter MST 250 0034.6623) | Fuse_TR5_P5.08mm | THT
3 | RL1,RL2,RL3 | 3 | Hongfa | HF115F/005-1ZS3 | HF115F/005-1ZS3 - Relay SPDT 16 A 250 VAC, 5 V coil 62 ohm (variant ...AF with AgSnO2 also fits) | Relay_THT_HF115F-1ZS3 | THT | Mains side: orientation per silkscreen; pin COM in the middle column
4 | U1 | 2 | generic | 1x15 female header 2.54 mm, 8.5 mm | NodeMCU Amica - NodeMCU Amica socket: 2 pcs, rows 22.86 mm apart | 2x PinSocket_1x15_P2.54mm (rows 22.86 mm) | THT | 2 x 1x15 female headers in the two rows of U1 (22.86 mm apart, NodeMCU Amica)
5 | J6 | 1 | JUSHUO | AFC07-S50ECA-00 | DWIN FPC50 - FPC connector 0.5 mm 50P, upper contact, slide lock, H 2.0 mm - BOTTOM SIDE | FPC_0.5mm_50P_AFC07 (bottom) | SMD | BOTTOM SIDE. Upper-contact FPC connector, opening towards the board's top edge (see silkscreen)
6 | R1,R3,R5,R18,R19 | 5 | UNI-ROYAL | 0805W8F1001T5E | 1k - Resistor 1 kohm 1% 0805 | R0805 | SMD | BOTTOM SIDE (all SMD parts are on the bottom side)
7 | R2,R4,R6,R16,R17 | 5 | UNI-ROYAL | 0805W8F1002T5E | 10k - Resistor 10 kohm 1% 0805 | R0805 | SMD | BOTTOM SIDE (all SMD parts are on the bottom side)
8 | Q1,Q2,Q3 | 3 | Shandong Jingdao | BC817-40 | BC817-40 - NPN 45 V 500 mA hFE 250-600, SOT-23 | SOT-23-3 | SMD | BOTTOM SIDE (all SMD parts are on the bottom side)
9 | D1,D2,D3 | 3 | Changjiang | 1N4148W | 1N4148W - Diode 100 V 150 mA SOD-123 | SOD-123 | SMD | BOTTOM SIDE. Diode: cathode bar towards +5V (see bottom silkscreen)
10 | J1 | 1 | Phoenix Contact | 1715721 (MKDS 1,5/2-5,08) | 5V IN - Screw terminal 2P 5.08 mm, 5 V input | TerminalBlock_P5.08mm_1x02 | THT
11 | F1 | 1 | Littelfuse | 1812L110/16DR | 1.1A PTC - PTC resettable 1.1 A hold 16 V 1812 | 1812 | SMD | BOTTOM SIDE (all SMD parts are on the bottom side)
12 | C1 | 1 | TWBOR | CJ221MD711B3 | 220uF 16V - Electrolytic 220 uF 16 V 6.3 x 11 mm, 2.5 mm | CP_Radial_D6.3mm_P2.50mm | THT | Electrolytic: + pad marked on silkscreen
13 | C2,C3 | 2 | Samsung | CL21B104KBCNNNC | 100nF - Capacitor 100 nF 50 V X7R 0805 | C0805 | SMD | BOTTOM SIDE (all SMD parts are on the bottom side)
14 | J3,J5 | 2 | JST | B4B-XH-A(LF)(SN) | B4B-XH-A(LF)(SN) - JST XH 4P vertical | JST_XH_B4B-XH-A_1x04_P2.50mm_Vertical | THT
 | Notes: |  |  |  | Quantity per board. SMT on the BOTTOM side only; all through-hole parts on the top side. U1 = 2 female headers 1x15. The board carries 230 VAC above the dashed silkscreen line.
