nachobh/thermostat/pcbway/thermostat_universal_rev_a/COLOCACION_THT_REFERENCIA.csv

Designator | X_mm_from_left | Y_mm_from_bottom | Side | Technology | Orientation
C1 | 84.130 | 45.362 | Top | THT | See silkscreen and assembly instructions; raw Fritzing rotation is not authoritative
C2 | 84.130 | 31.251 | Top | THT | See silkscreen and assembly instructions; raw Fritzing rotation is not authoritative
C3 | 84.130 | 17.140 | Top | THT | See silkscreen and assembly instructions; raw Fritzing rotation is not authoritative
C7 | 6.519 | 67.940 | Top | THT | See silkscreen and assembly instructions; raw Fritzing rotation is not authoritative
C8 | 15.367 | 66.289 | Top | THT | See silkscreen and assembly instructions; raw Fritzing rotation is not authoritative
C9 | 6.519 | 58.062 | Top | THT | See silkscreen and assembly instructions; raw Fritzing rotation is not authoritative
C10 | 15.367 | 56.411 | Top | THT | See silkscreen and assembly instructions; raw Fritzing rotation is not authoritative
F1 | 10.967 | 87.085 | Top | THT | See silkscreen and assembly instructions; raw Fritzing rotation is not authoritative
J1 | 13.981 | 93.738 | Top | THT | See silkscreen and assembly instructions; raw Fritzing rotation is not authoritative
J2 | 25.955 | 93.738 | Top | THT | See silkscreen and assembly instructions; raw Fritzing rotation is not authoritative
J3 | 9.022 | 77.369 | Top | THT | See silkscreen and assembly instructions; raw Fritzing rotation is not authoritative
J4 | 59.822 | 63.258 | Top | THT | See silkscreen and assembly instructions; raw Fritzing rotation is not authoritative
J5 | 44.300 | 77.369 | Top | THT | See silkscreen and assembly instructions; raw Fritzing rotation is not authoritative
J6 | 64.055 | 77.369 | Top | THT | See silkscreen and assembly instructions; raw Fritzing rotation is not authoritative
J7 | 83.811 | 77.369 | Top | THT | See silkscreen and assembly instructions; raw Fritzing rotation is not authoritative
J8 | 27.528 | 63.258 | Top | THT | See silkscreen and assembly instructions; raw Fritzing rotation is not authoritative
J9 | 7.772 | 49.147 | Top | THT | See silkscreen and assembly instructions; raw Fritzing rotation is not authoritative
J10 | 73.772 | 63.258 | Top | THT | See silkscreen and assembly instructions; raw Fritzing rotation is not authoritative
J11 | 92.569 | 43.453 | Top | THT | See silkscreen and assembly instructions; raw Fritzing rotation is not authoritative
J12 | 92.569 | 29.342 | Top | THT | See silkscreen and assembly instructions; raw Fritzing rotation is not authoritative
J13 | 92.569 | 15.231 | Top | THT | See silkscreen and assembly instructions; raw Fritzing rotation is not authoritative
Q1 | 75.607 | 43.778 | Top | THT | See silkscreen and assembly instructions; raw Fritzing rotation is not authoritative
Q2 | 75.607 | 29.667 | Top | THT | See silkscreen and assembly instructions; raw Fritzing rotation is not authoritative
Q3 | 75.607 | 15.556 | Top | THT | See silkscreen and assembly instructions; raw Fritzing rotation is not authoritative
R1 | 38.488 | 45.286 | Top | THT | See silkscreen and assembly instructions; raw Fritzing rotation is not authoritative
R2 | 58.244 | 45.286 | Top | THT | See silkscreen and assembly instructions; raw Fritzing rotation is not authoritative
R3 | 38.488 | 31.174 | Top | THT | See silkscreen and assembly instructions; raw Fritzing rotation is not authoritative
R4 | 58.244 | 31.174 | Top | THT | See silkscreen and assembly instructions; raw Fritzing rotation is not authoritative
R5 | 38.488 | 17.063 | Top | THT | See silkscreen and assembly instructions; raw Fritzing rotation is not authoritative
R6 | 58.244 | 17.063 | Top | THT | See silkscreen and assembly instructions; raw Fritzing rotation is not authoritative
R10 | 24.377 | 45.286 | Top | THT | See silkscreen and assembly instructions; raw Fritzing rotation is not authoritative
R11 | 24.377 | 38.230 | Top | THT | See silkscreen and assembly instructions; raw Fritzing rotation is not authoritative
R12 | 38.488 | 67.863 | Top | THT | See silkscreen and assembly instructions; raw Fritzing rotation is not authoritative
R13 | 42.721 | 60.808 | Top | THT | See silkscreen and assembly instructions; raw Fritzing rotation is not authoritative
R14 | 13.088 | 62.219 | Top | THT | See silkscreen and assembly instructions; raw Fritzing rotation is not authoritative
R15 | 72.355 | 53.752 | Top | THT | See silkscreen and assembly instructions; raw Fritzing rotation is not authoritative
R16 | 39.899 | 52.341 | Top | THT | See silkscreen and assembly instructions; raw Fritzing rotation is not authoritative
R17 | 59.655 | 53.752 | Top | THT | See silkscreen and assembly instructions; raw Fritzing rotation is not authoritative
