nachobh/thermostat/carcasa/stl_v8/ensamblado.stl

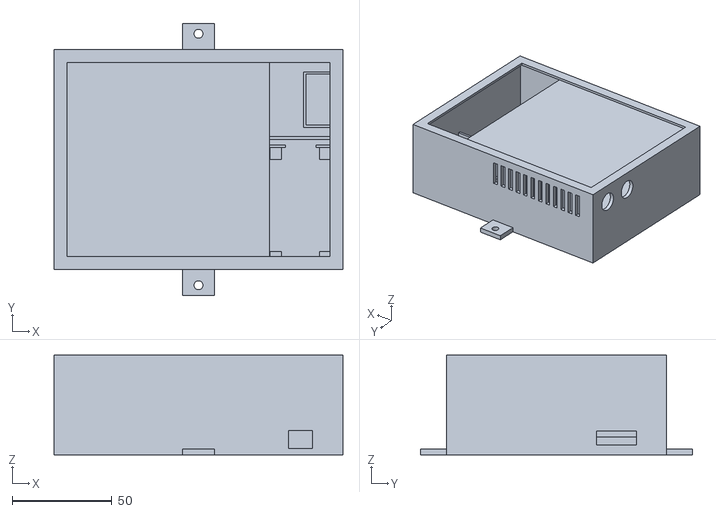
[picture p58: CAD file, 2026-10-22]
carcasa/stl_v8/ensamblado.stl
144.8 x 136.2 x 50.0
