nachobh/thermostat/carcasa/stl/ensamblado.stl

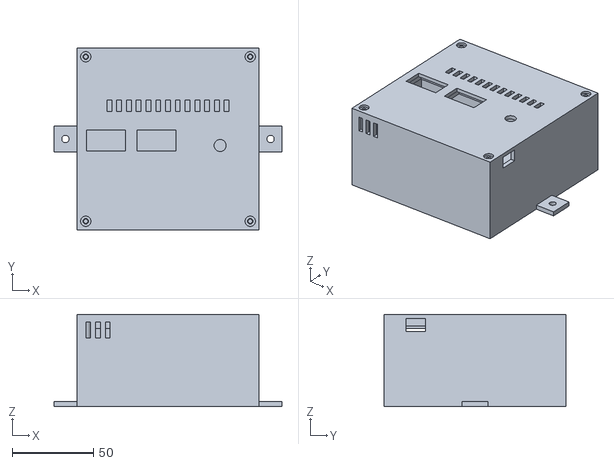
[picture p59: CAD file, 2026-10-22]
carcasa/stl/ensamblado.stl
140.0 x 112.0 x 56.5
