nachobh/thermostat/carcasa/stl/tapa.stl

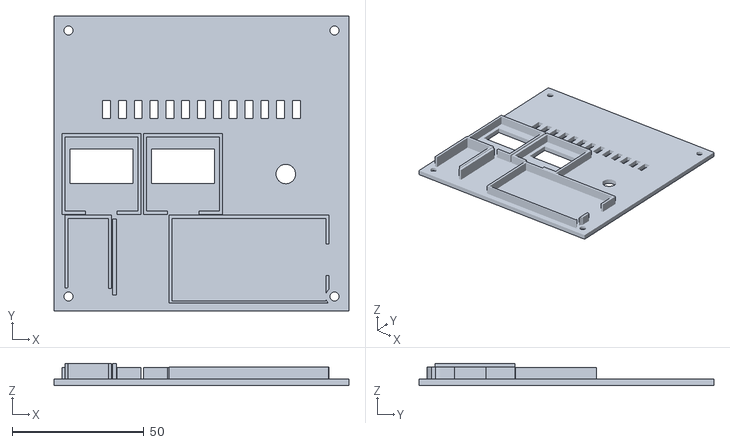
[picture p60: CAD file, 2026-10-22]
carcasa/stl/tapa.stl
112.0 x 112.0 x 8.50
