nachobh/thermostat/carcasa/stl_v8/tapa_cubierta.stl

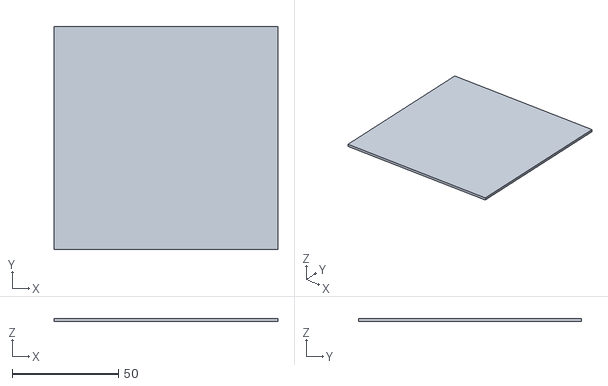
[picture p61: CAD file, 2026-10-22]
carcasa/stl_v8/tapa_cubierta.stl
105.3 x 104.8 x 1.50
