nachobh/thermostat/carcasa/stl/bandeja.stl

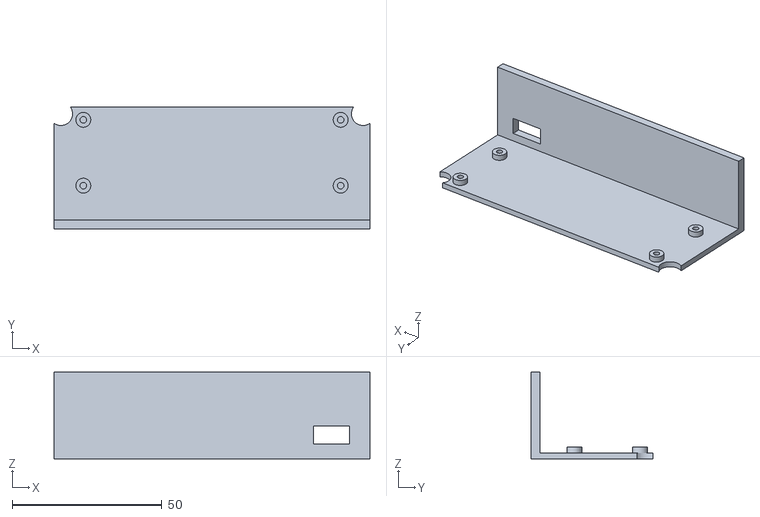
[picture p62: CAD file, 2026-10-22]
carcasa/stl/bandeja.stl
105.6 x 40.8 x 29.0
