nachobh/thermostat/carcasa/stl_v8/cubierta.stl

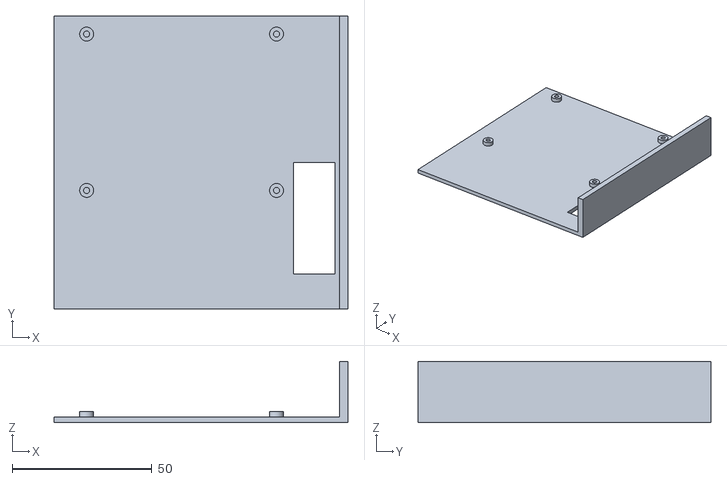
[picture p63: CAD file, 2026-10-22]
carcasa/stl_v8/cubierta.stl
105.3 x 104.8 x 22.0
