nachobh/thermostat/carcasa/stl/carcasa.stl

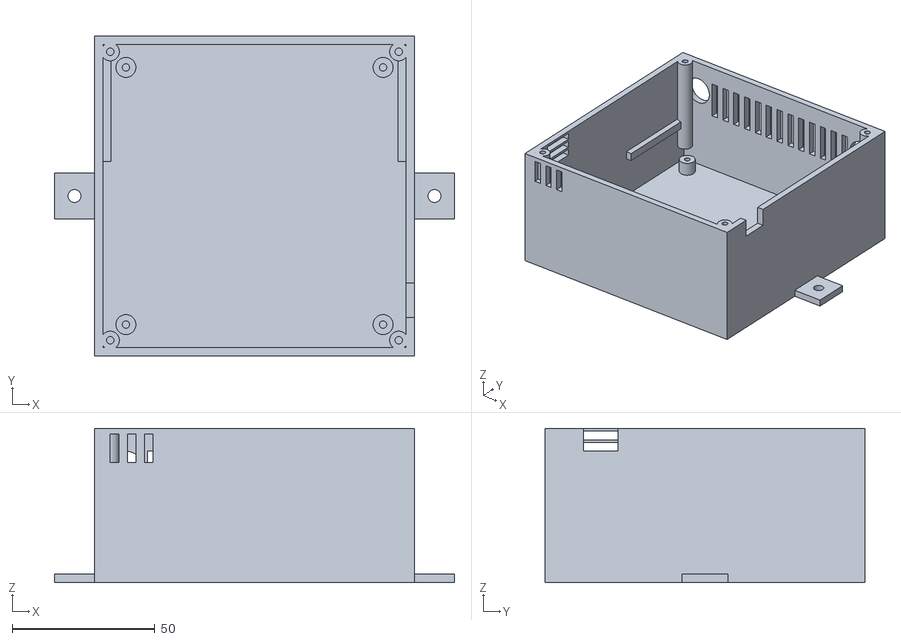
[picture p64: CAD file, 2026-10-22]
carcasa/stl/carcasa.stl
140.0 x 112.0 x 54.0
