nachobh/thermostat/carcasa/stl_v8/carcasa.stl

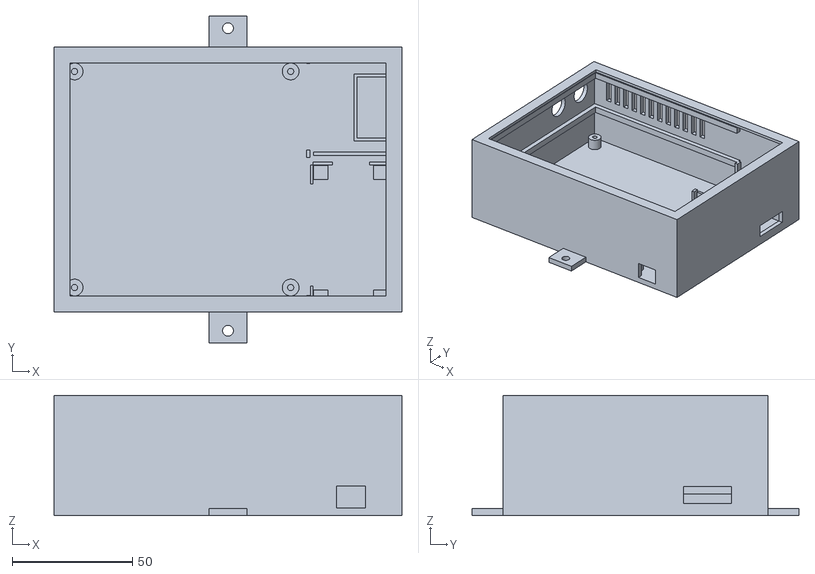
[picture p65: CAD file, 2026-10-22]
carcasa/stl_v8/carcasa.stl
144.8 x 136.2 x 50.0
