nachobh/thermostat/carcasa/stl_v6/ensamblado.stl

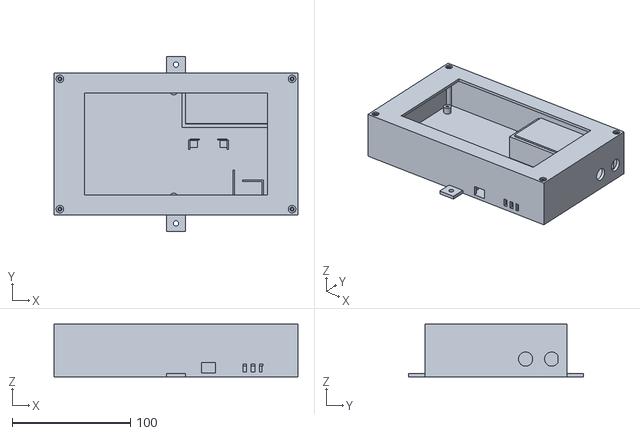
[picture p66: CAD file, 2026-10-22, an earlier design]
carcasa/stl_v6/ensamblado.stl
206.0 x 148.0 x 44.5
