nachobh/thermostat/carcasa/stl_v7/ensamblado.stl

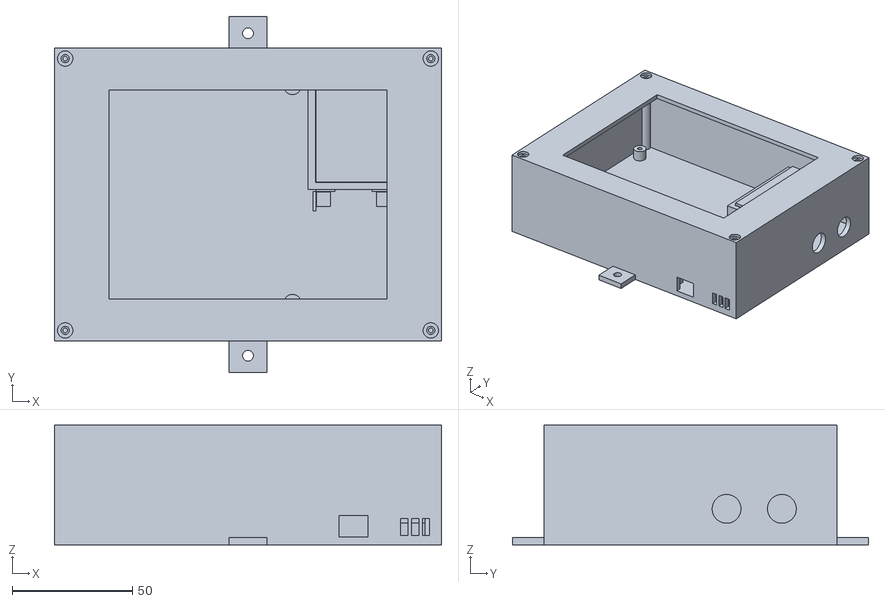
[picture p67: CAD file, 2026-10-22, an earlier design]
carcasa/stl_v7/ensamblado.stl
161.0 x 148.0 x 49.8
