nachobh/thermostat/carcasa/stl_v5/ensamblado.stl

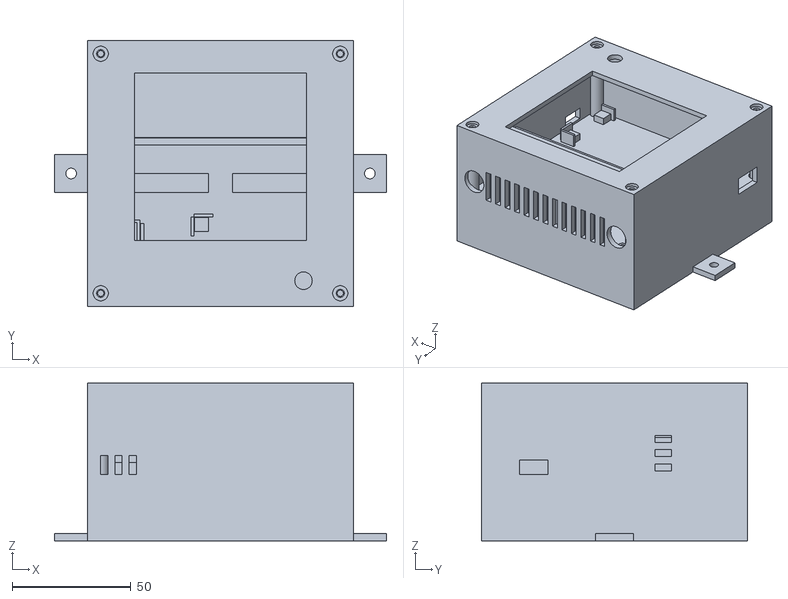
[picture p68: CAD file, 2026-10-22, an earlier design]
carcasa/stl_v5/ensamblado.stl
140.0 x 112.0 x 66.5
