nachobh/thermostat/carcasa/stl_v5/cubierta.stl

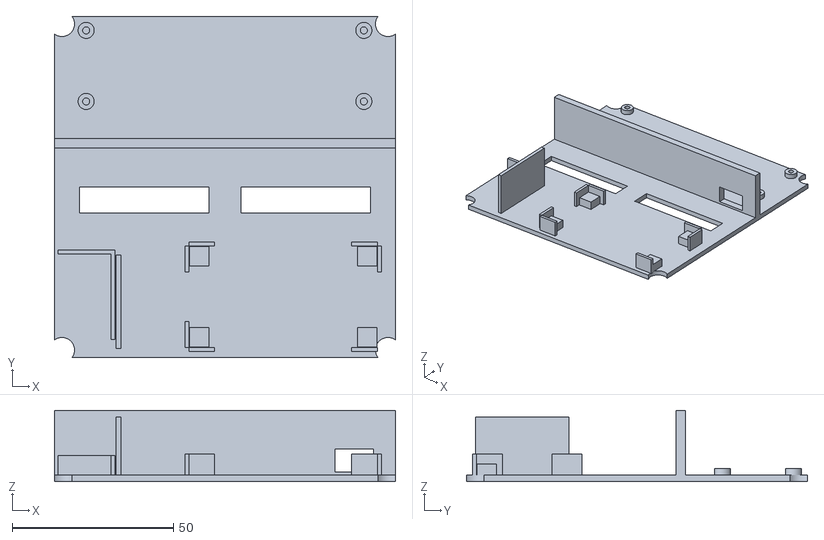
[picture p69: CAD file, 2026-10-22, an earlier design]
carcasa/stl_v5/cubierta.stl
105.6 x 105.6 x 22.0
