nachobh/thermostat/carcasa/stl_v6/cubierta_bolsa.stl

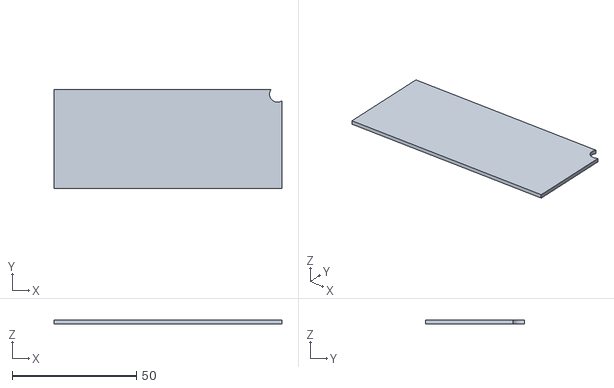
[picture p70: CAD file, 2026-10-22, an earlier design]
carcasa/stl_v6/cubierta_bolsa.stl
91.6 x 39.6 x 1.50
