nachobh/thermostat/carcasa/stl_v7/carcasa.stl

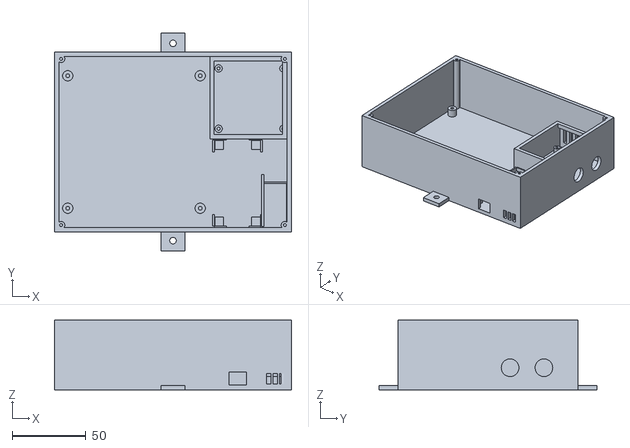
[picture p71: CAD file, 2026-10-22, an earlier design]
carcasa/stl_v7/carcasa.stl
161.0 x 148.0 x 47.3
