nachobh/thermostat/carcasa/stl_v5/cubierta_bolsa.stl

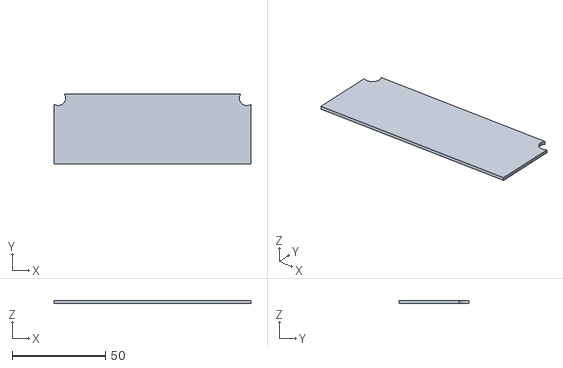
[picture p72: CAD file, 2026-10-22, an earlier design]
carcasa/stl_v5/cubierta_bolsa.stl
105.6 x 37.6 x 1.50
