nachobh/thermostat/carcasa/stl_v5/carcasa.stl

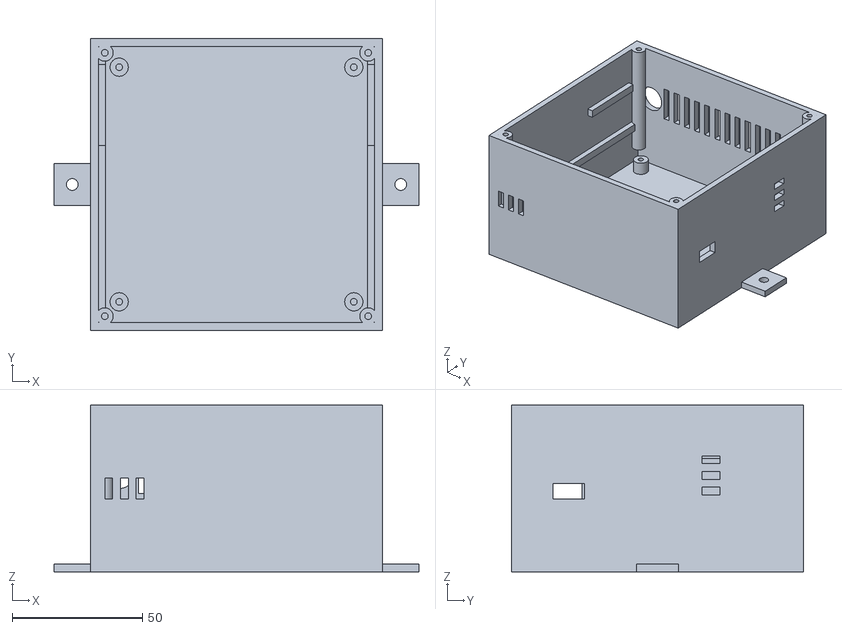
[picture p73: CAD file, 2026-10-22, an earlier design]
carcasa/stl_v5/carcasa.stl
140.0 x 112.0 x 64.0
