nachobh/thermostat/carcasa/stl_v6/tapa.stl

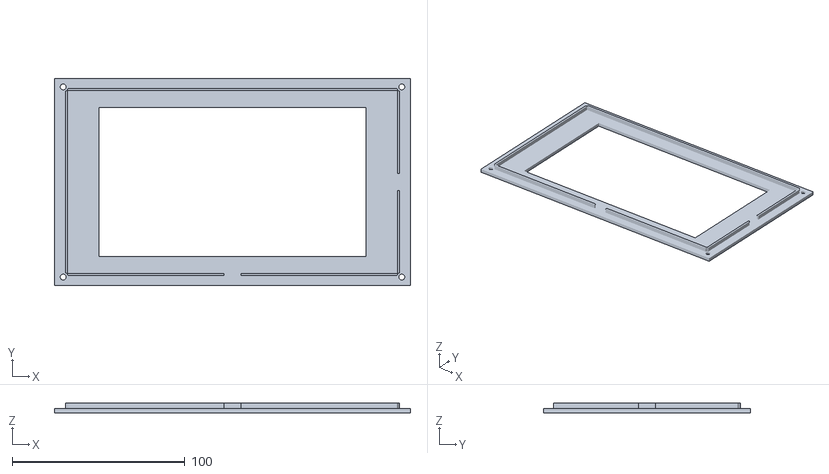
[picture p74: CAD file, 2026-10-22, an earlier design]
carcasa/stl_v6/tapa.stl
206.0 x 120.0 x 5.50
