nachobh/thermostat/carcasa/stl_v7/tapa.stl

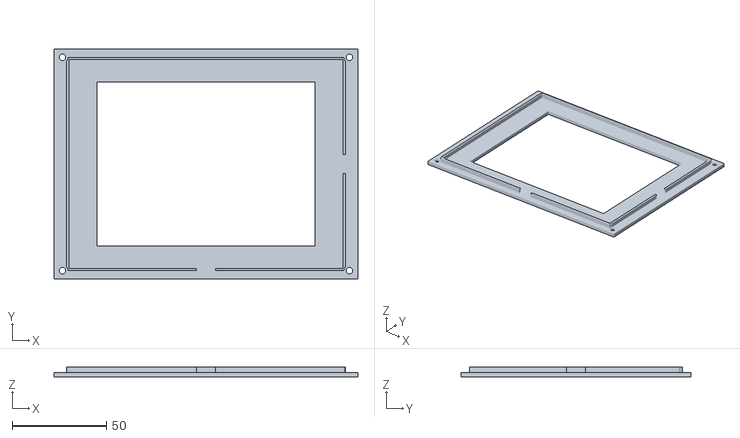
[picture p75: CAD file, 2026-10-22, an earlier design]
carcasa/stl_v7/tapa.stl
161.0 x 122.0 x 5.50
