nachobh/thermostat/(list of files, cad)

Other CAD files:
carcasa/stl_v5/tapa.stl
carcasa/stl_v6/carcasa.stl
carcasa/stl_v7/cubierta_bolsa.stl
