nachobh/thermostat/pcbway/thermostat_rev_c/PARA_SUBIR_PCBWAY/ASSEMBLY_DRAWING_REV_C.pdf

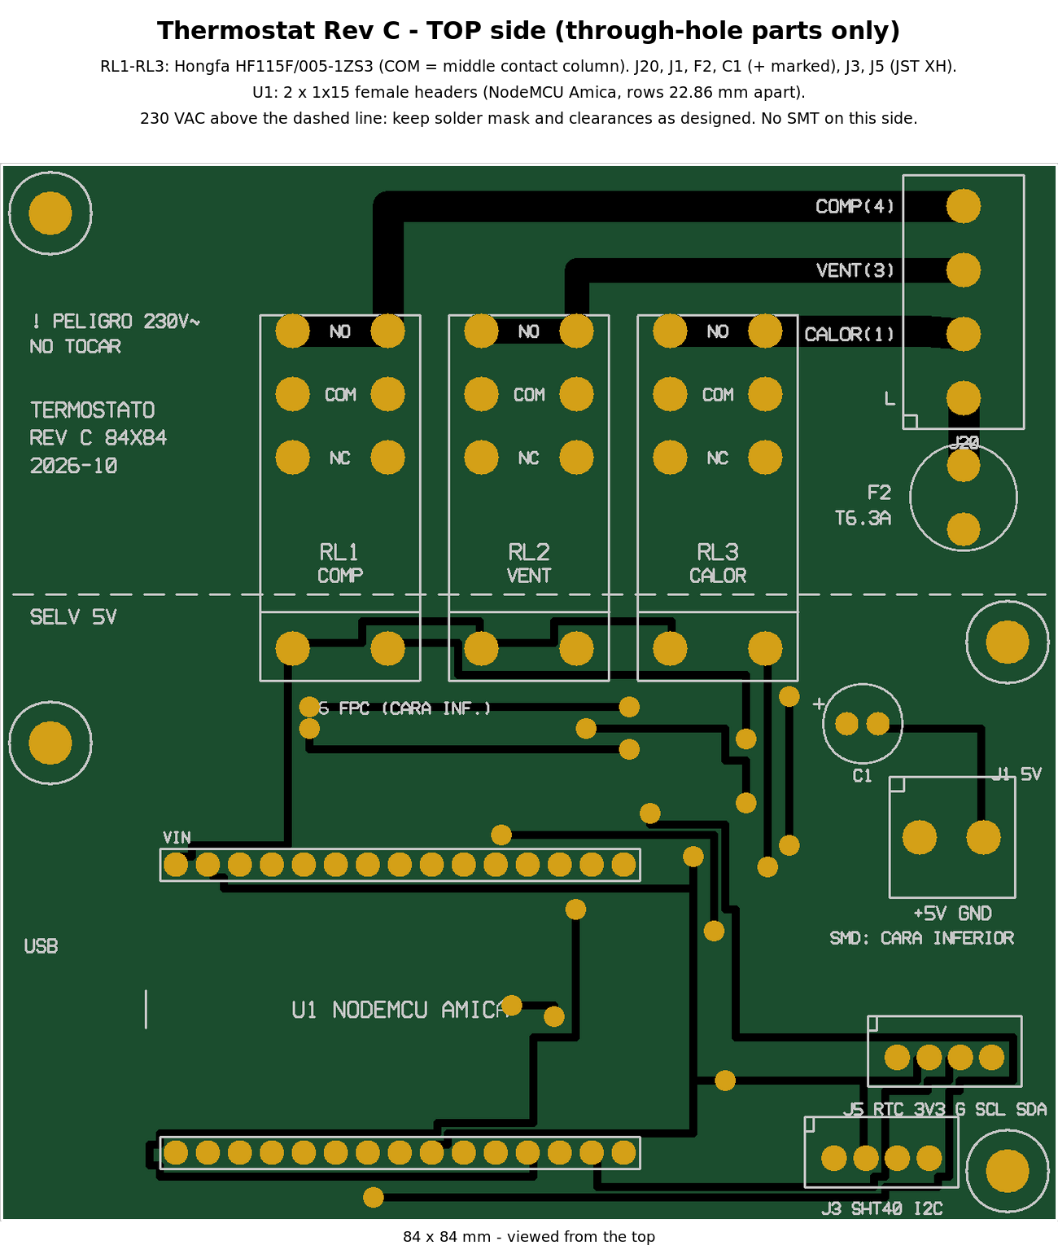
[picture p76: page 1]
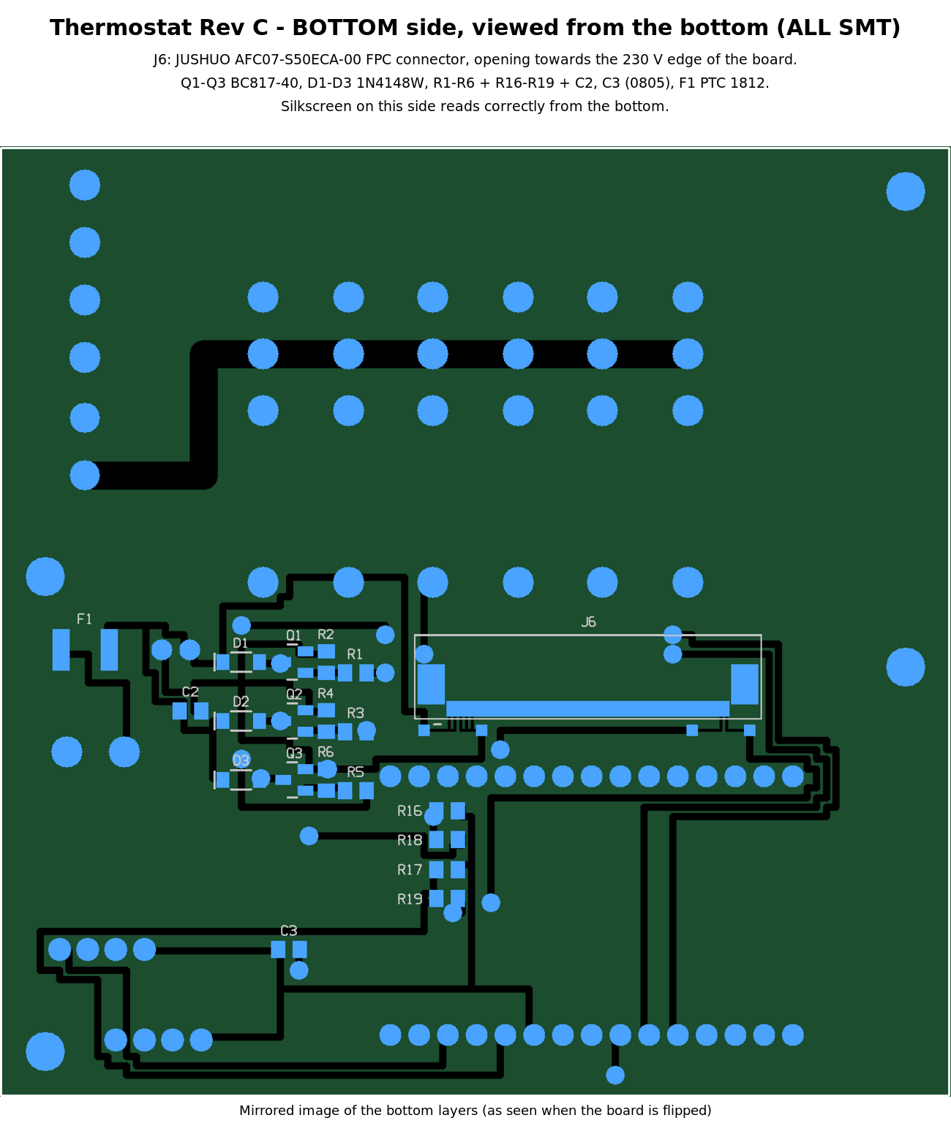
[picture p77: page 2]
