nachobh/thermostat/carcasa/stl_ensamblado.png

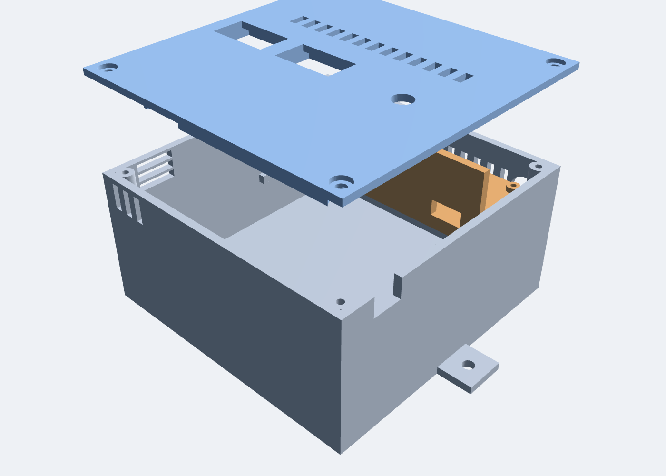
carcasa/stl_ensamblado.png
