nachobh/thermostat/carcasa/stl_v5_ensamblado.png

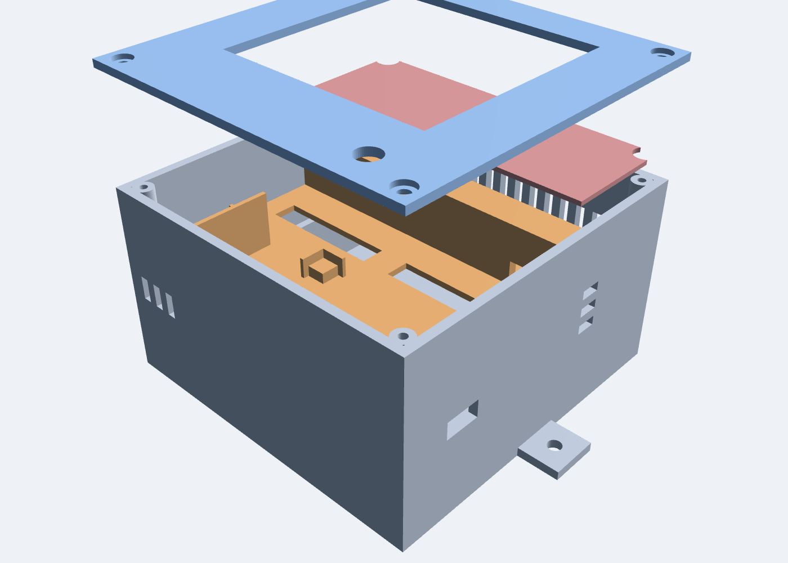
carcasa/stl_v5_ensamblado.png
