nachobh/thermostat/carcasa/stl_v6_ensamblado.png

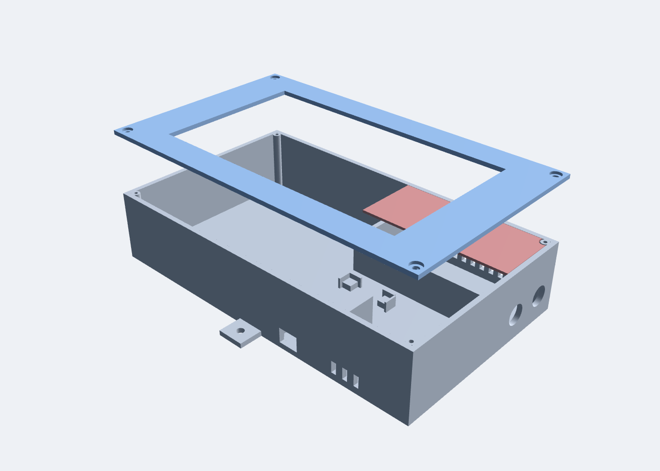
carcasa/stl_v6_ensamblado.png
