nachobh/thermostat/carcasa/stl_v7_ensamblado.png

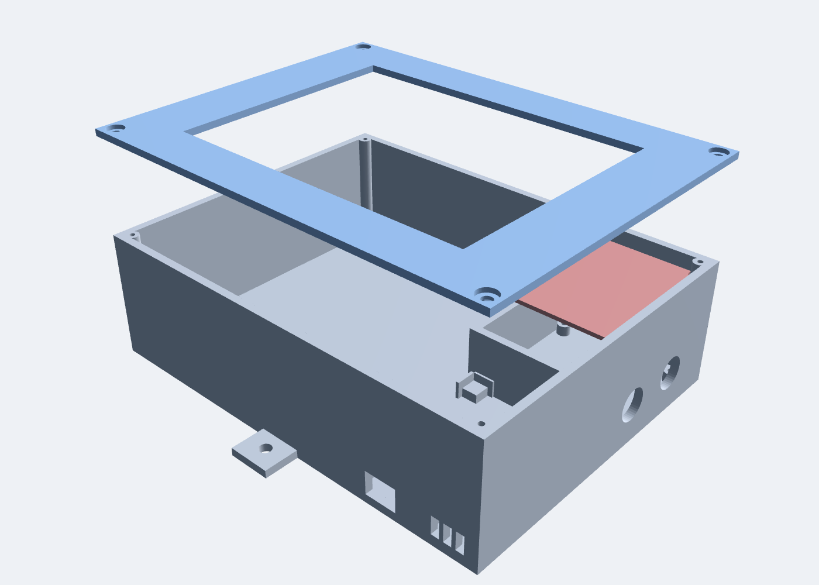
carcasa/stl_v7_ensamblado.png
