nachobh/thermostat/carcasa/stl_v8_ensamblado.png

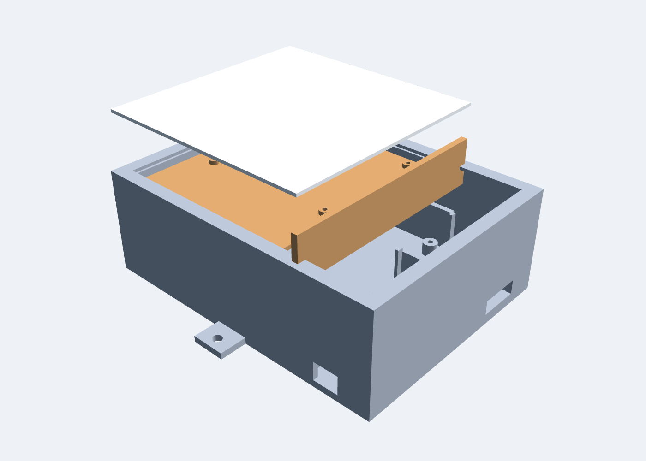
carcasa/stl_v8_ensamblado.png
