nachobh/thermostat/pcbway/thermostat_rev_c/VERIFICACION_BOTTOM.png

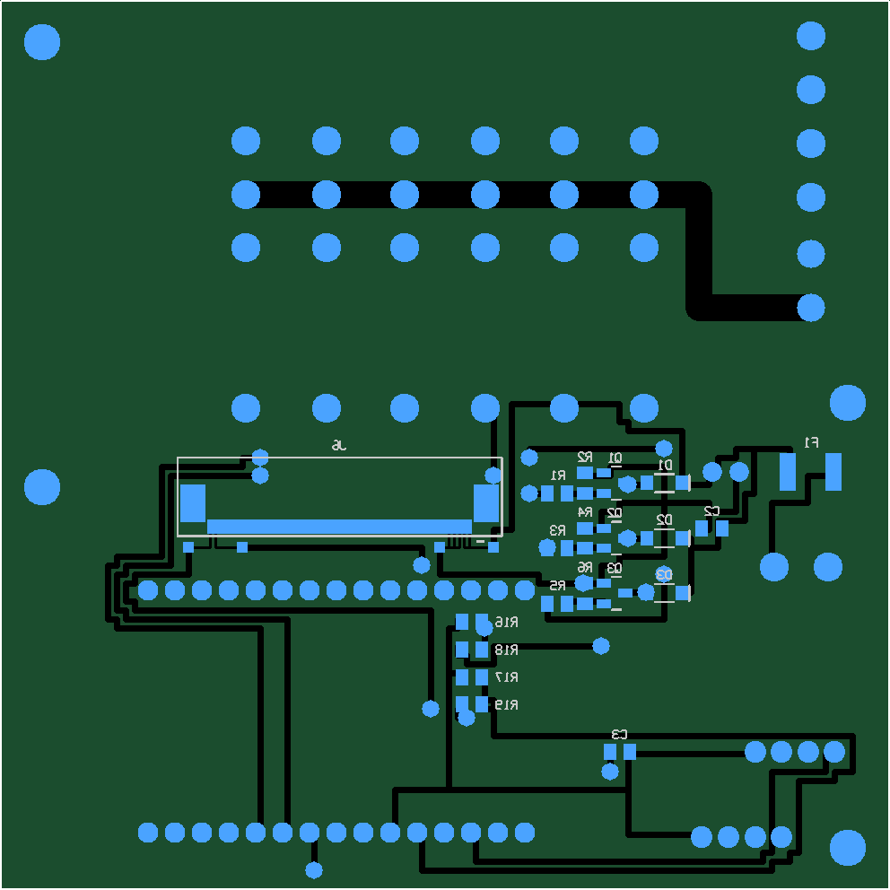
pcbway/thermostat_rev_c/VERIFICACION_BOTTOM.png
