nachobh/thermostat/pcbway/thermostat_rev_c/VERIFICACION_TOP.png

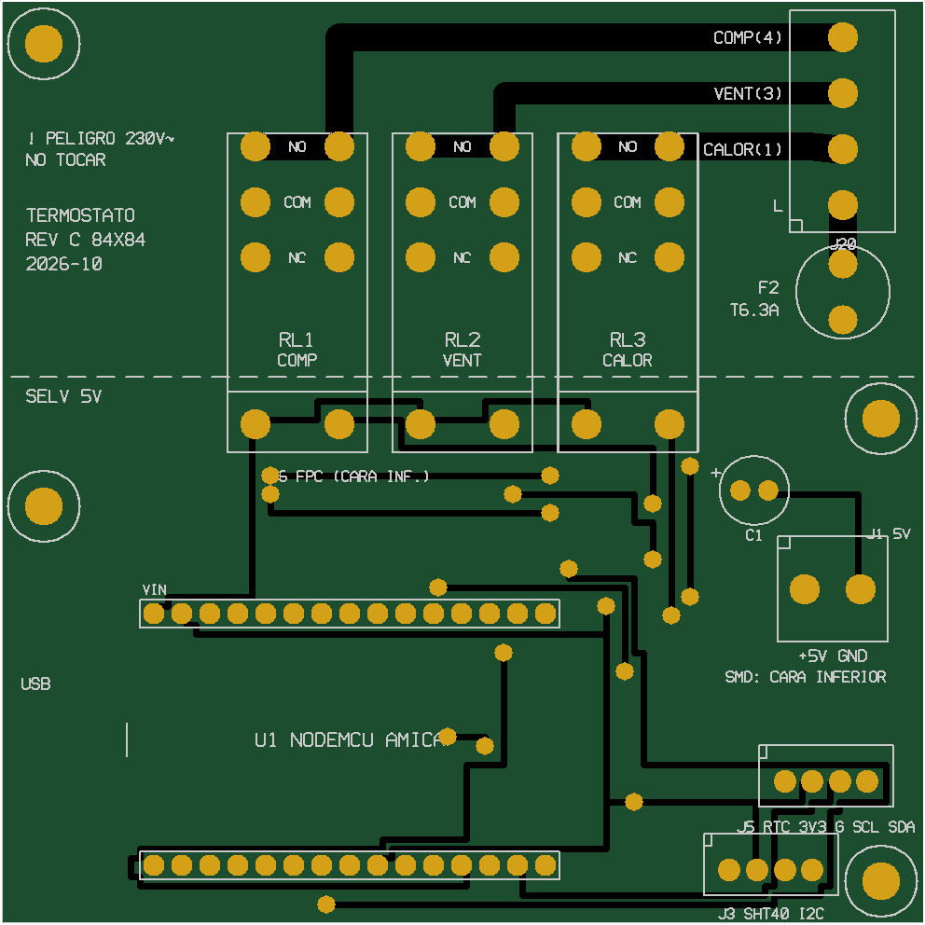
pcbway/thermostat_rev_c/VERIFICACION_TOP.png
