nachobh/thermostat/pcbway/thermostat_universal_rev_a/VERIFICACION_BOTTOM.png

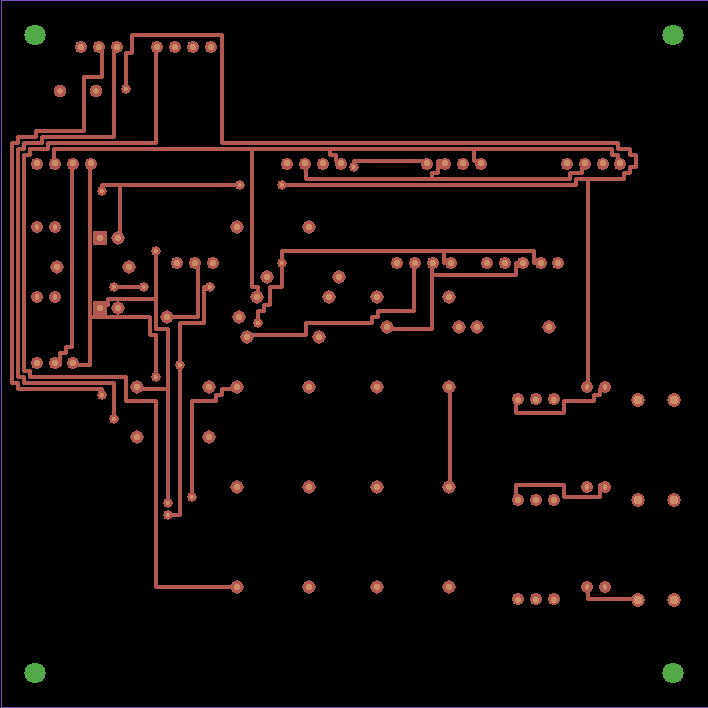
pcbway/thermostat_universal_rev_a/VERIFICACION_BOTTOM.png
