nachobh/thermostat/pcbway/thermostat_universal_rev_a/VERIFICACION_ESQUEMA.png

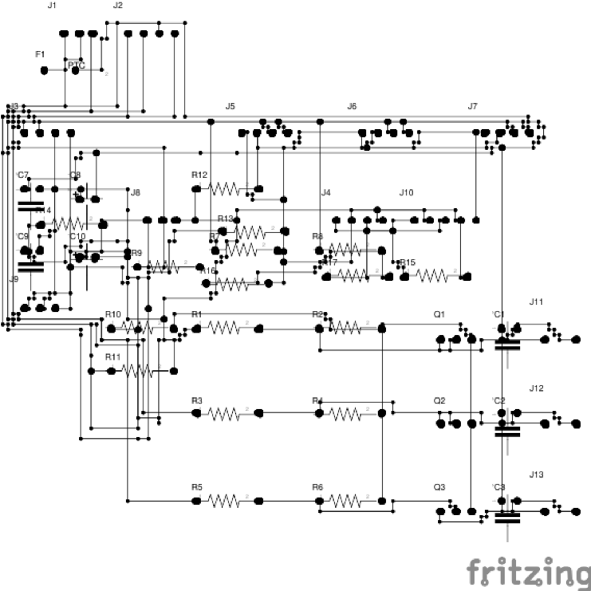
pcbway/thermostat_universal_rev_a/VERIFICACION_ESQUEMA.png
