nachobh/thermostat/pcbway/thermostat_universal_rev_a/VERIFICACION_TOP.png

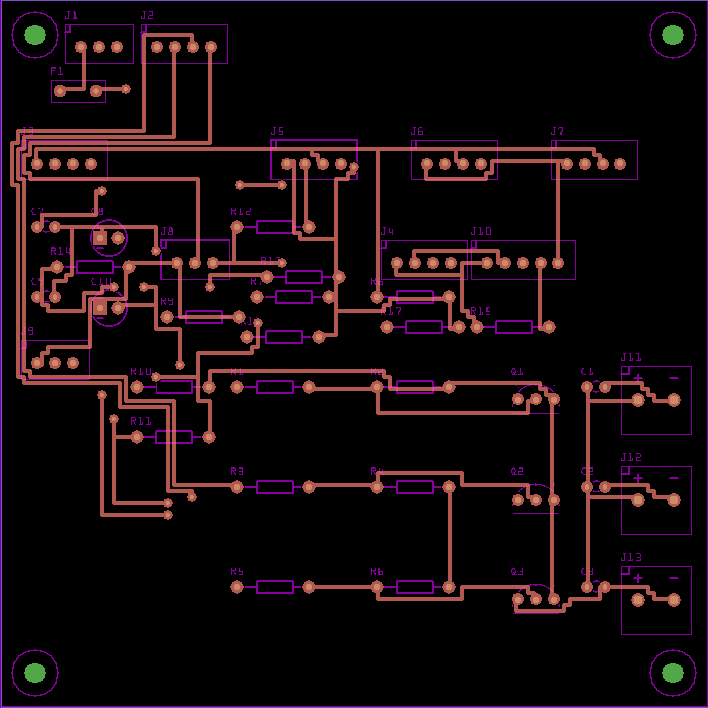
pcbway/thermostat_universal_rev_a/VERIFICACION_TOP.png
