nachobh/thermostat/thermostat_universal.pdf

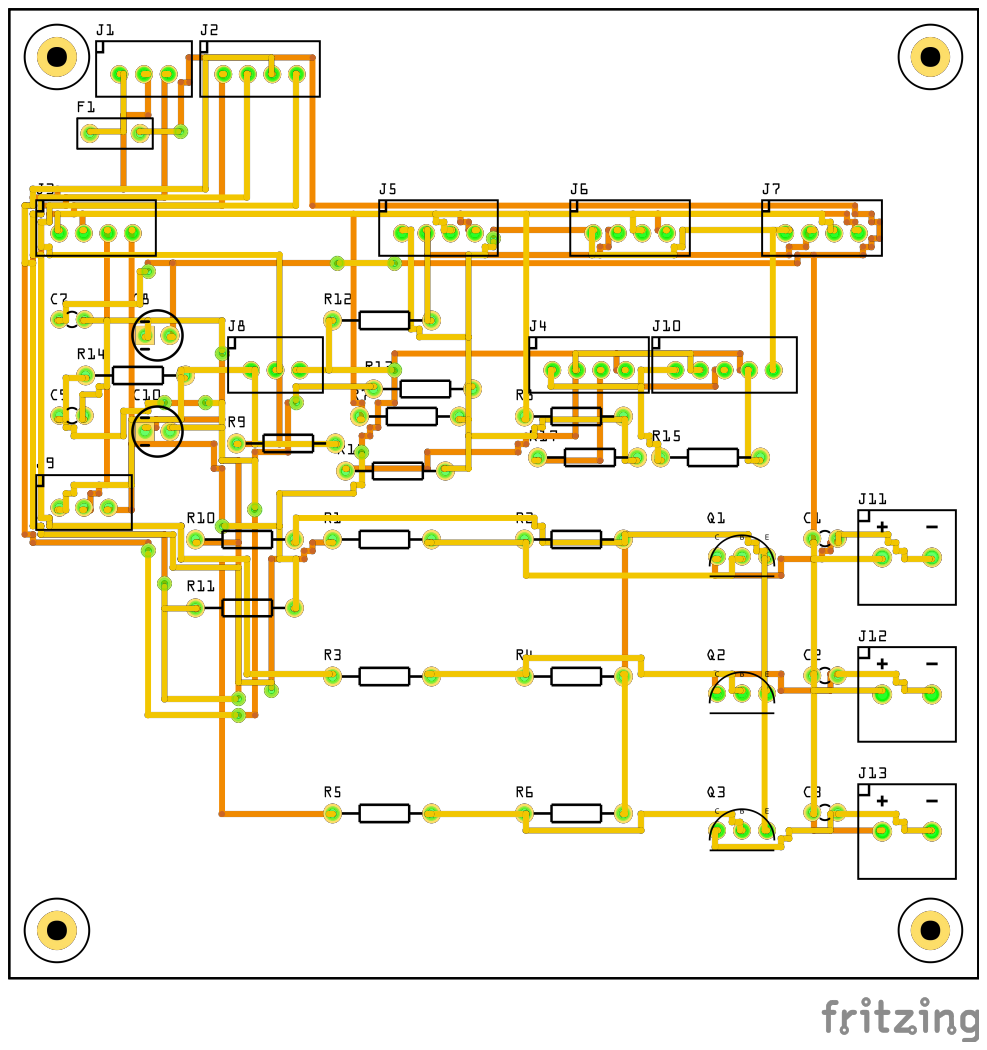
[picture p88: page 1]
