nachobh/thermostat/pcbway/thermostat_universal_rev_a/PLANTILLA_1_A_1.pdf

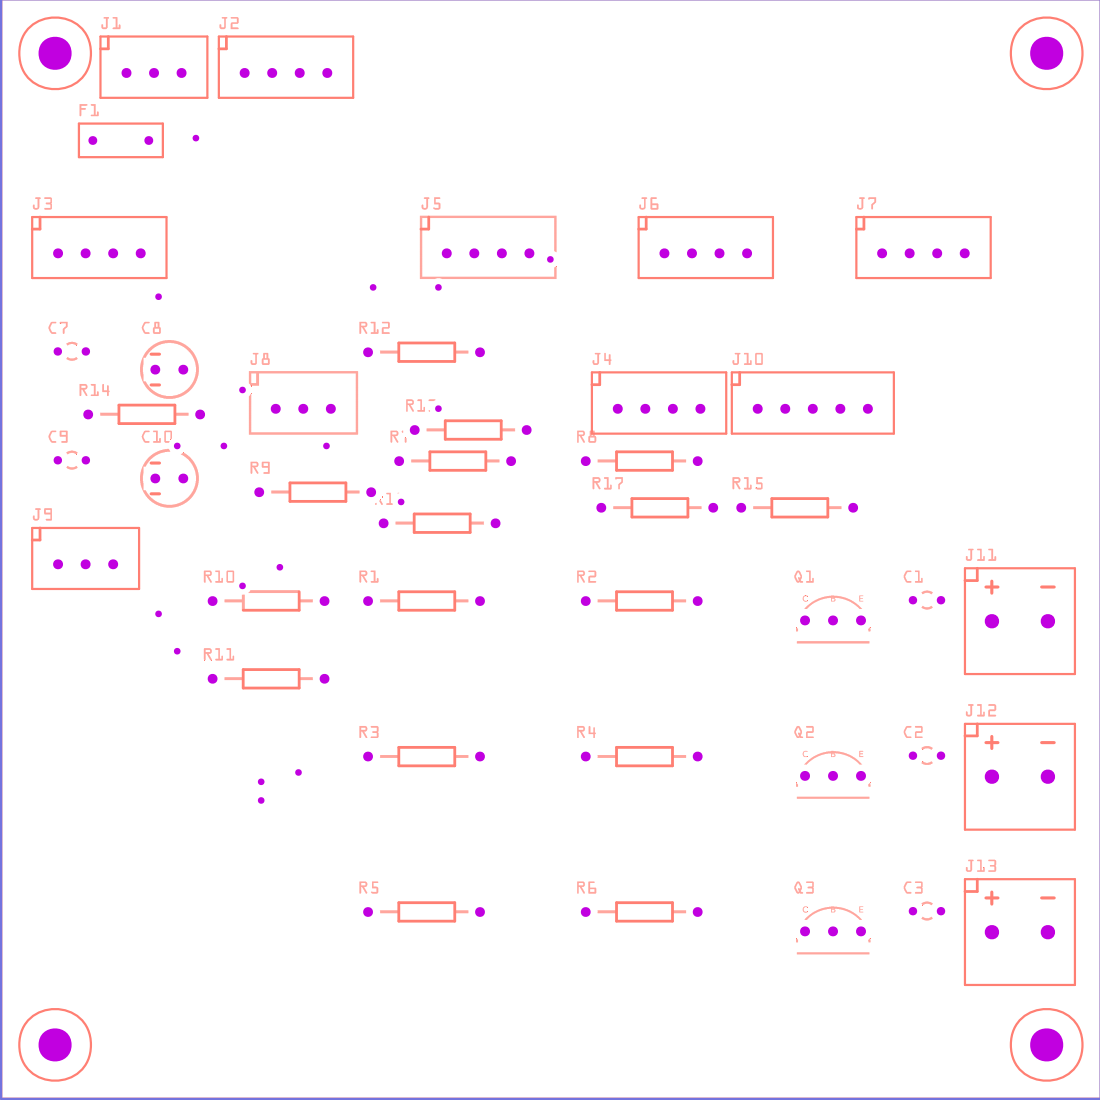
[picture p89: page 1]
