nachobh/thermostat/(list of files, drawings)

Other design files:
pcbway/thermostat_universal_rev_a/thermostat_universal.fzz
sketch.fzz
sketch_bkp.fzz
sketch_pcb.fzz
thermostat_rev_b.fzz
thermostat_rev_c.fzz
