nachobh/thermostat/(commit log)

2020-12-21 Buttons for menu and select added. Switch for on/off working. Few tweaks
2020-12-21 Little tweak for clearing the screens when switched off
2026-10-22 Versions B and C created and final elements along with render and files for PCBWay, JLCPLC, NextPCB
